bigtreetech/BTT-E3-RRF/BTT E3 RRF V1.1/3D/3D.png

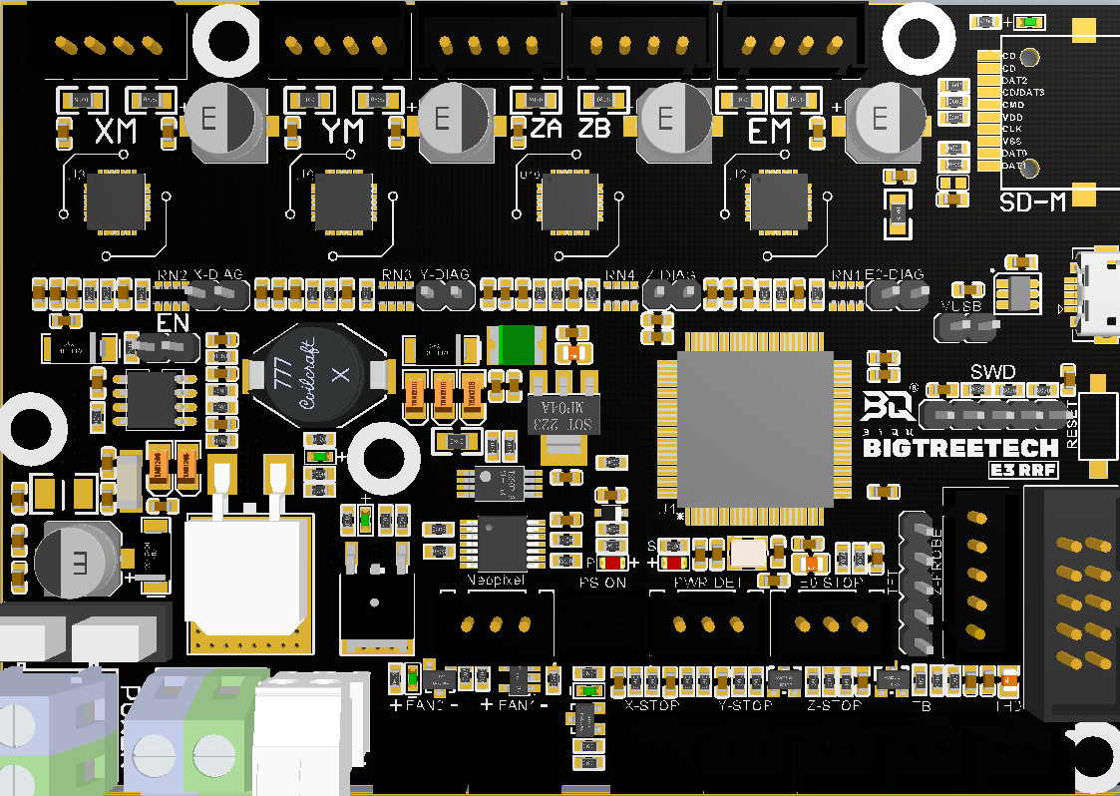
BTT E3 RRF V1.1/3D/3D.png
