bigtreetech/BTT-E3-RRF/README.md

## BTT-E3-RRF

### review
　You can find a complete review with detailed features of our electronics in [Spanish](https://3dwork.io/bigtreetech-e3-rrf) and [English](https://3dwork.io/en/bigtreetech-e3-rrf) on [3dwork.io](https://3dwork.io/).
