bigtreetech/BTT-E3-RRF/BTT E3 RRF V1.1/Firmware/RepRapFirmware/Ender3-IDEX/readme.md

# Firmware

Please download the latest version from https://github.com/gloomyandy/RepRapFirmware/releases  
The board is supported from release 3.3b1_5
