bigtreetech/BTT-E3-RRF/BTT E3 RRF V1.1/Firmware/E3 RRF 用户手册-For RepRapFirmware.pdf

前言

只有您需要 DIY 升级功能您才需要查看此文档，如果您是基础版的机器，直接更新我们 github 中预编译的 firmware.bin 文件即可正常使用。您可以在 Duet3D 官网找到所有配置的 详情，https://duet3d.dozuki.com/Wiki/Gcode。

一、 DWC(Duet Web Control)

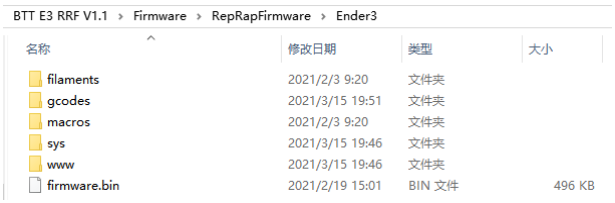
[picture p32: figure]

将我们 github 中的配置文件放到 SD 卡根目录，将卡插到主板然后 Reset，主板会自动更新 固件，更新成功后发送“M997 S1”更新 ESP8266 中的固件。
先发送 “M552 S0” 使 ESP8266 进入空闲模式，然后发送” M587 S"SSID" P"Password” “ 设置 要连接的 WIFI 名称和密码，然后发送“M552 S1” 使能网络控制，ESP8266 连接到 WIFI 后会 返回一个 IP 地址，在同一个局域网下的其他设备可以直接在浏览器中输入这个 IP 地址去访 问 DWC 界面

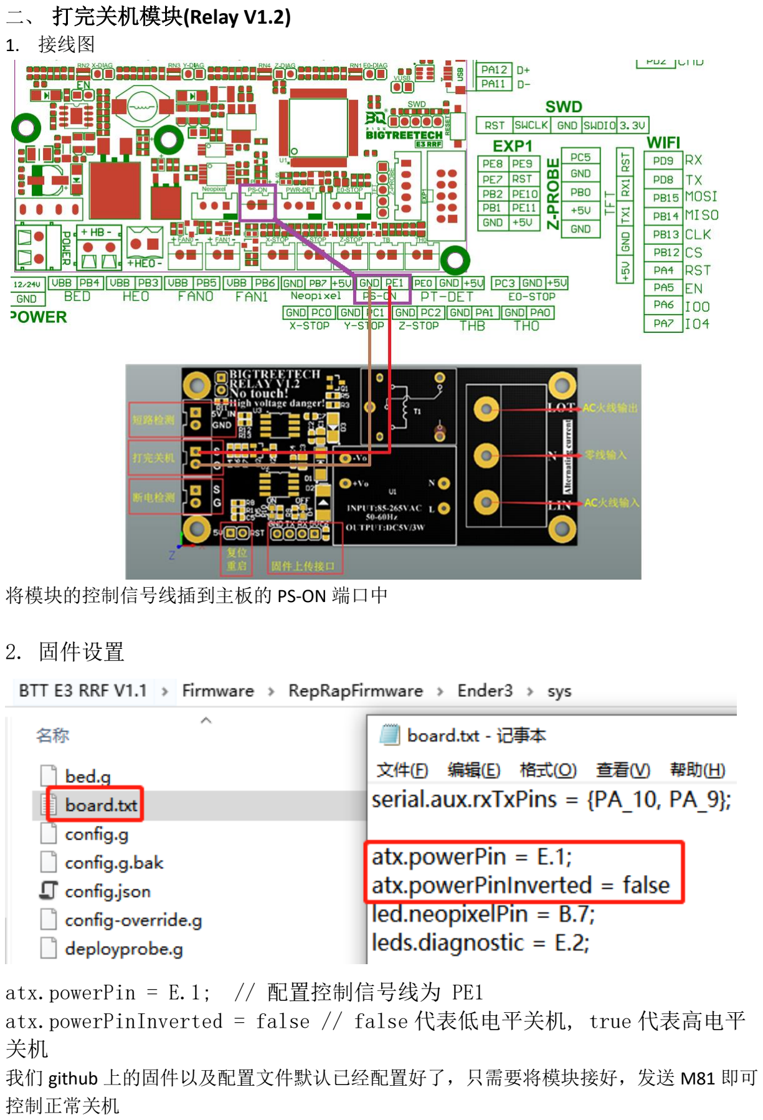
[picture p33: page 2]

二、 打完关机模块(Relay V1.2)
1. 接线图

将模块的控制信号线插到主板的 PS-ON 端口中

2. 固件设置

atx.powerPin = E.1; // 配置控制信号线为 PE1 atx.powerPinInverted = false // false 代表低电平关机, true 代表高电平 关机
我们 github 上的固件以及配置文件默认已经配置好了，只需要将模块接好，发送 M81 即可 控制正常关机

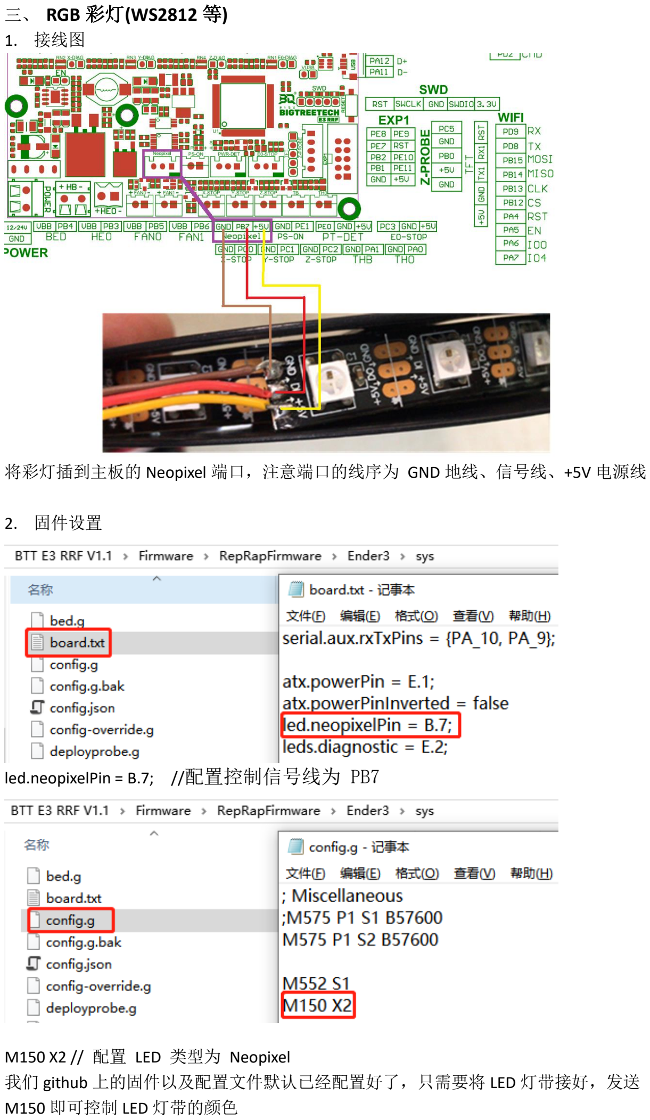
[picture p34: page 3]

三、 RGB 彩灯(WS2812 等)
1. 接线图

将彩灯插到主板的 Neopixel 端口，注意端口的线序为 GND 地线、信号线、+5V 电源线

2. 固件设置

led.neopixelPin = B.7; //配置控制信号线为 PB7

M150 X2 // 配置 LED 类型为 Neopixel
我们 github 上的固件以及配置文件默认已经配置好了，只需要将 LED 灯带接好，发送 M150 即可控制 LED 灯带的颜色

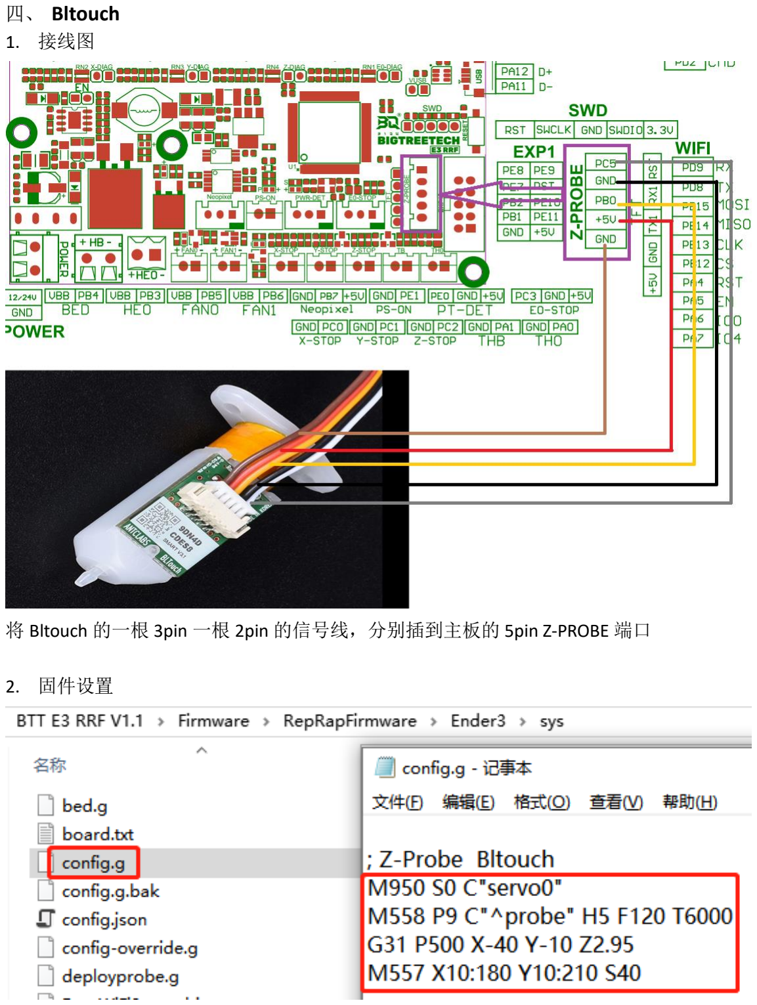
[picture p35: page 4]

四、 Bltouch
1. 接线图

将 Bltouch 的一根 3pin 一根 2pin 的信号线，分别插到主板的 5pin Z-PROBE 端口

2. 固件设置

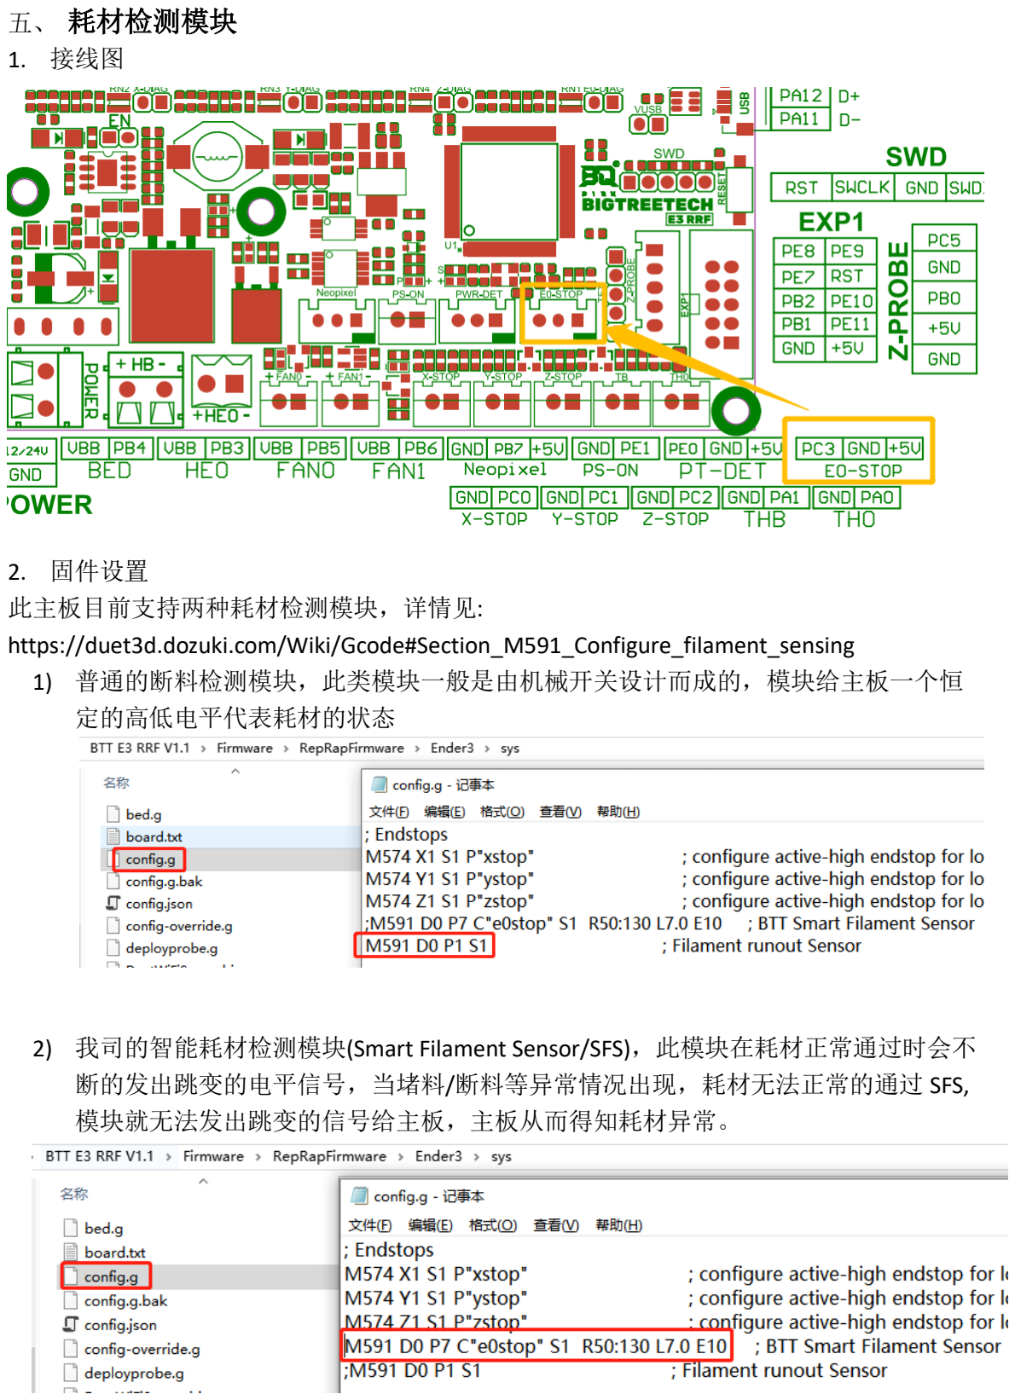
[picture p36: page 5]

五、 耗材检测模块
1. 接线图
2. 固件设置
此主板目前支持两种耗材检测模块，详情见:
https://duet3d.dozuki.com/Wiki/Gcode#Section_M591_Configure_filament_sensing
1) 普通的断料检测模块，此类模块一般是由机械开关设计而成的，模块给主板一个恒 定的高低电平代表耗材的状态
2) 我司的智能耗材检测模块(Smart Filament Sensor/SFS)，此模块在耗材正常通过时会不 断的发出跳变的电平信号，当堵料/断料等异常情况出现，耗材无法正常的通过 SFS, 模块就无法发出跳变的信号给主板，主板从而得知耗材异常。

六、 串口触控屏

设置屏幕的波特率为 57600(与 RRF 一致)

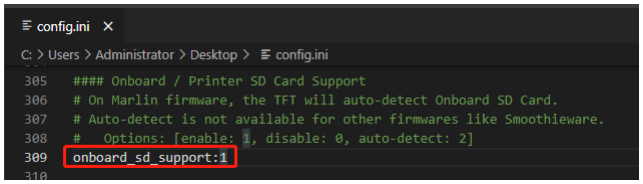
[picture p37: figure]

支持板载的 SD 卡

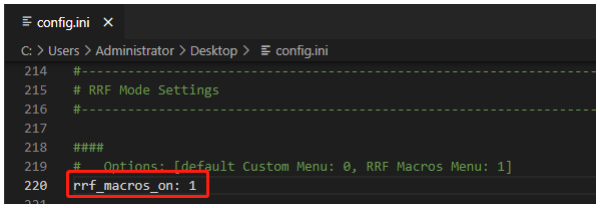
[picture p38: figure]

使能 Macros 界面
