bigtreetech/BTT-E3-RRF/BTT E3 RRF V1.1/Hardware/接线图.png

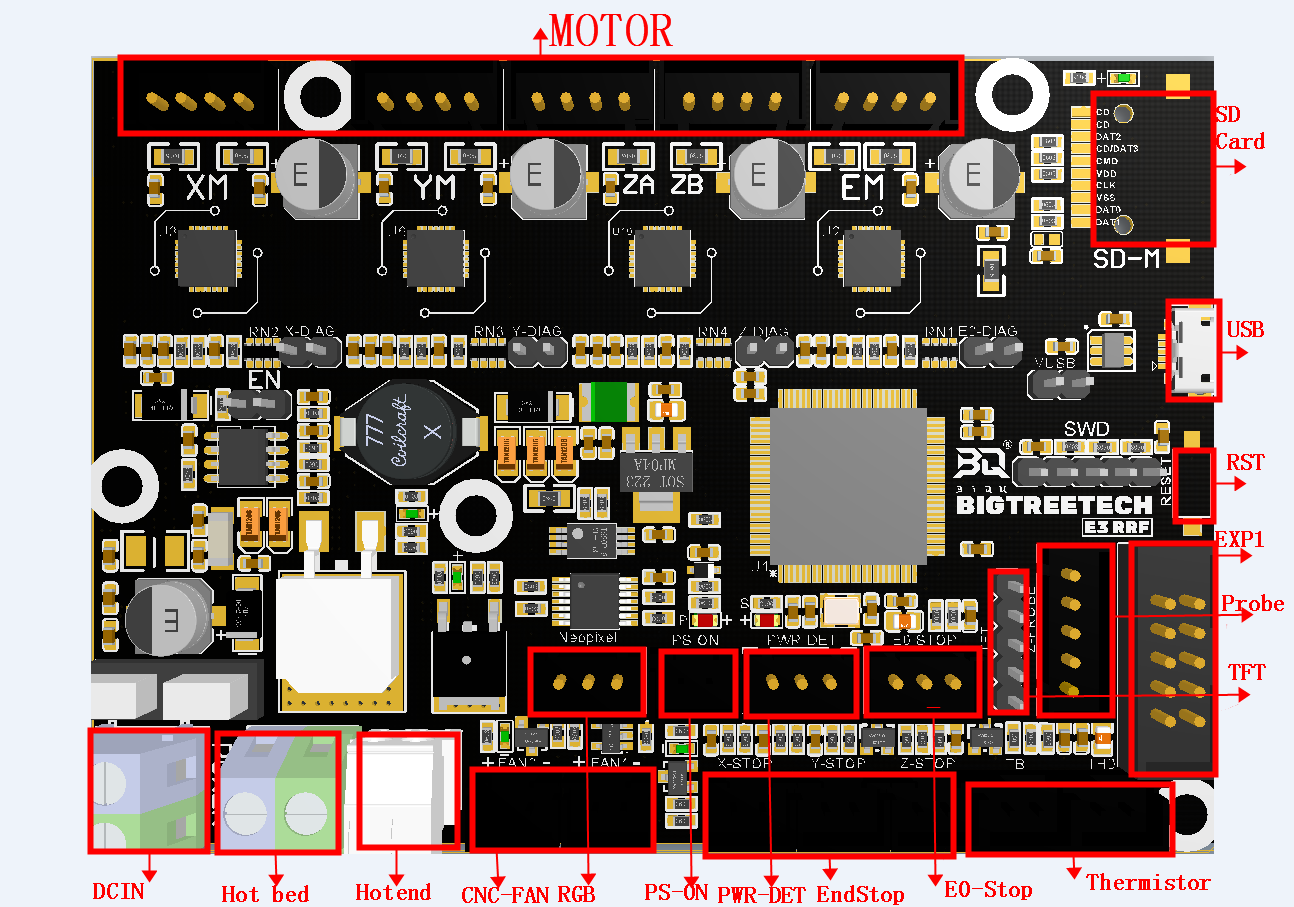
BTT E3 RRF V1.1/Hardware/接线图.png
