bigtreetech/BTT-E3-RRF/BTT E3 RRF V1.1/3D/ENDER32.STL

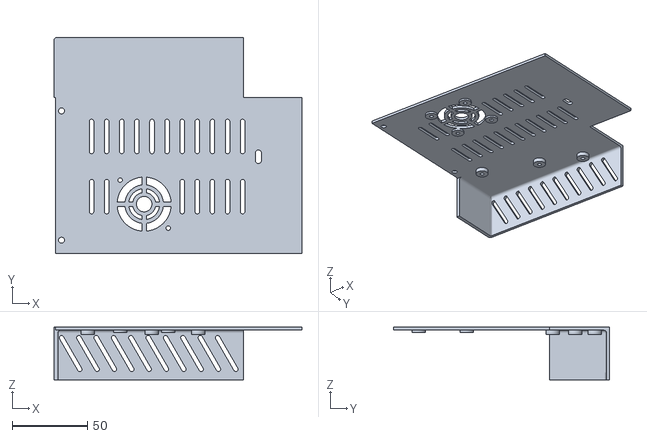
[picture p40: CAD file, 2021-05-18]
BTT E3 RRF V1.1/3D/ENDER32.STL
165.0 x 144.0 x 35.0
