bigtreetech/BTT-E3-RRF/BTT E3 RRF V1.1/3D/ENDER31.STL

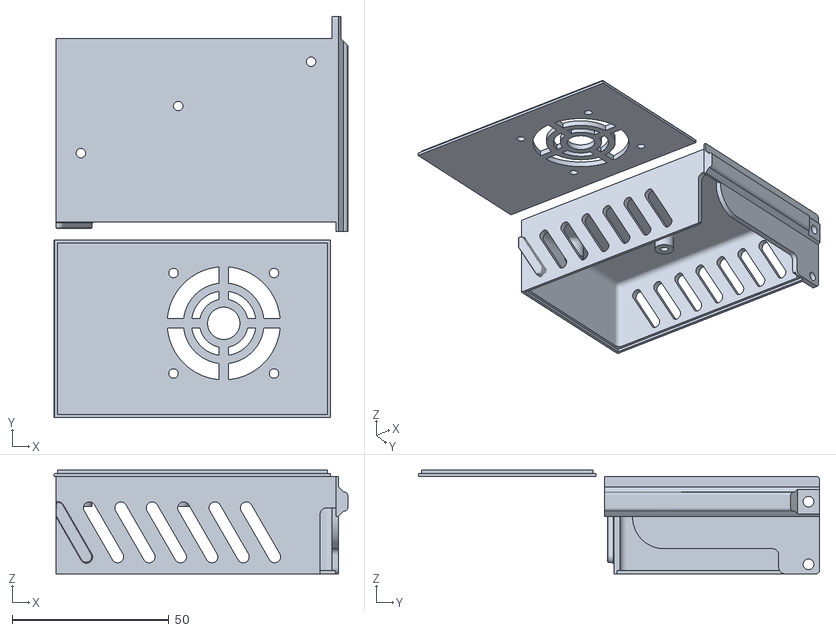
[picture p41: CAD file, 2021-05-18]
BTT E3 RRF V1.1/3D/ENDER31.STL
93.5 x 127.7 x 33.0
