bigtreetech/BTT-E3-RRF/BTT E3 RRF V1.1/Hardware/Support printer.txt

Support printer£º
		Ender-3¡¢Ender-3S¡¢Ender-3S Pro¡¢Ender-5¡¢CR-10¡¢CR-10mini¡¢Ender-3 V2
