bigtreetech/BTT-E3-RRF/BTT E3 RRF V1.1/Hardware/TUTORIAL ESP3D ENGLISH.pdf

## Build firmware ESP3D for BigTreeTech E3 RRF

Download in source firmware : ESP3D 2.1.1

1 : Extract ESP3D-2.1.1.zip (https://github.com/So6Rallye/BTT-E3-RRF-Marlin-2.0.7.2-wifi/blob/main/SOURCE%20FIRMWARE/ESP3D/ESP3D-2.1.1.zip) and copy the extract folder to the folder of your choice.

2 : Open Vscode and go to platformio extension. With platformio add folder ESP3D-2.1.1 extract previously.

3 : Now you need to configure the file platformio.ini for the wifi module ESP07S.

replace the parameters « dev » by :

| [env:esp07s] platform = espressif8266 board = esp07s framework = arduino monitor_speed = 115200

board_build.f_cpu = 80000000L board_build.f_flash = 40000000L
| board_build.flash_mode = qio
| you need to get this:

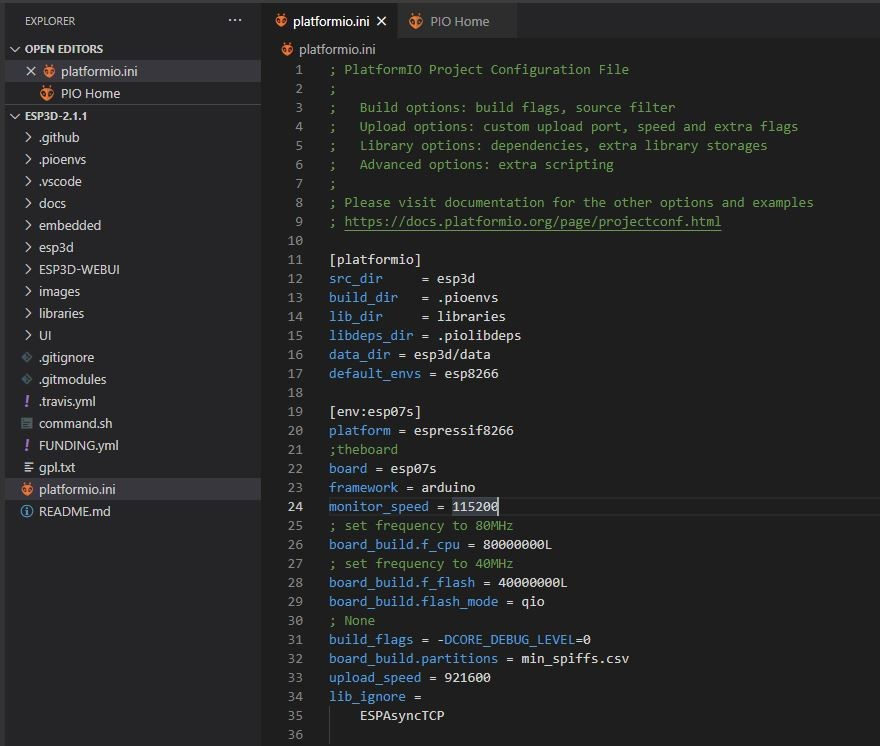
[picture p48: figure]

4 : Once these parameters are added you can successfully compile the firmware for ESP3D.

5 : the firmware is located in the starting ESP3D folder D:\USER\Document\ ESP3D-2.1.1\ESP3D-2.1.1\.pioenvs\esp8266

6 : Rename the firmware.bin file to ESP3D.bin

7 : Now all you have to do is copy this file into your SD card, insert it into your motherboard and turn on your printer. Wait a moment and your firmware is installed!

8 : Your printer is now available on your network, but there are still a few settings to activate so that your user interface works and your printer can connect to your network on its own.

9 : In your network manager connect you to ESP3D, open your browser and enter the base address 192.168.0.1 , the password is 12345678 .

10 : you are now connected to your printer, you will need to add the missing files in order to complete the configuration of your user interface.

11 : Go to your ESP3D folder and go to the folder D:\USER\Document\ESP3D-2.1.1\ESP3D-2.1.1\esp3d\data

you must find this:

404
favicon
index.html

12 : copy the three files into your web interface and click upload

13 : Once the download is complete you can proceed to the web interface configuration step.

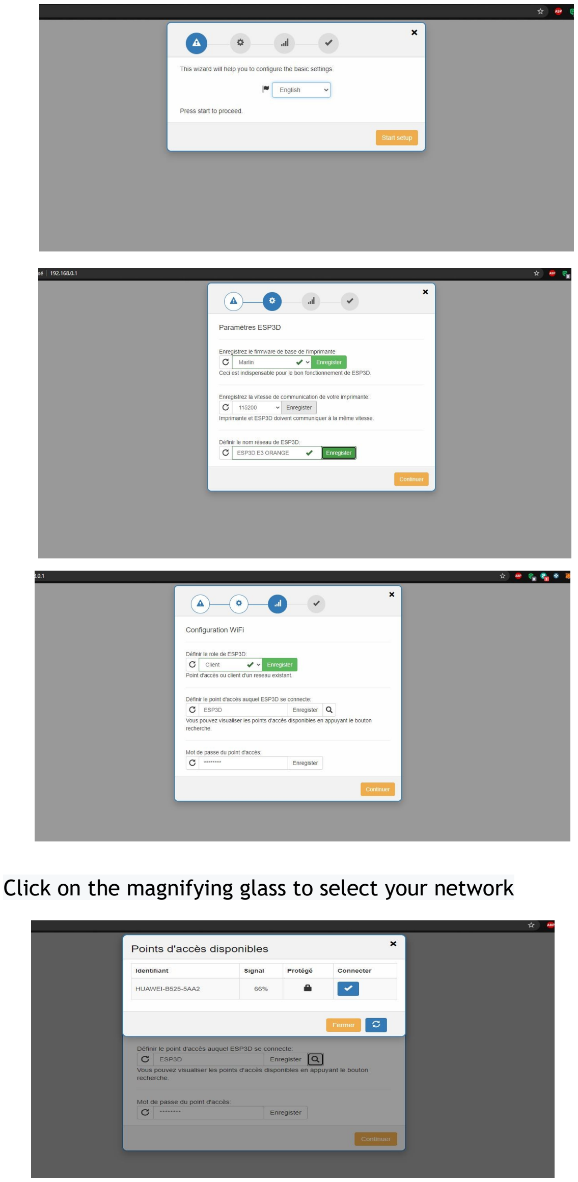
[picture p49: page 3]

Click on the magnifying glass to select your network

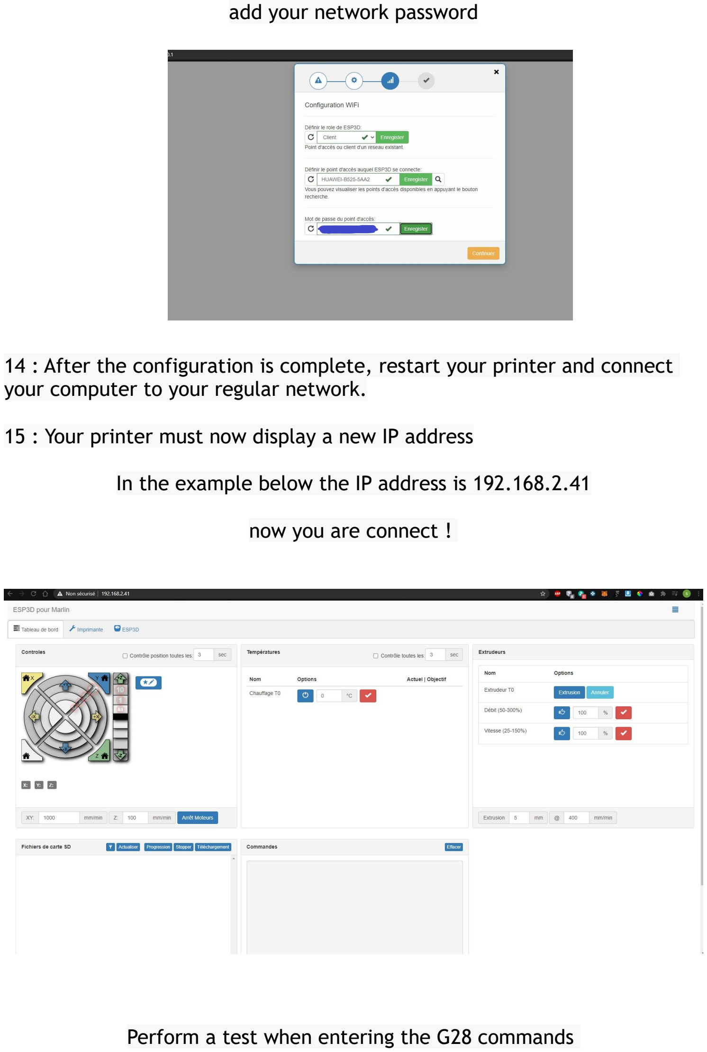
[picture p50: page 4]

add your network password

14 : After the configuration is complete, restart your printer and connect your computer to your regular network.

15 : Your printer must now display a new IP address

In the example below the IP address is 192.168.2.41

now you are connect !

Perform a test when entering the G28 commands your printer communicates with your network and realizes are AUTOHOME

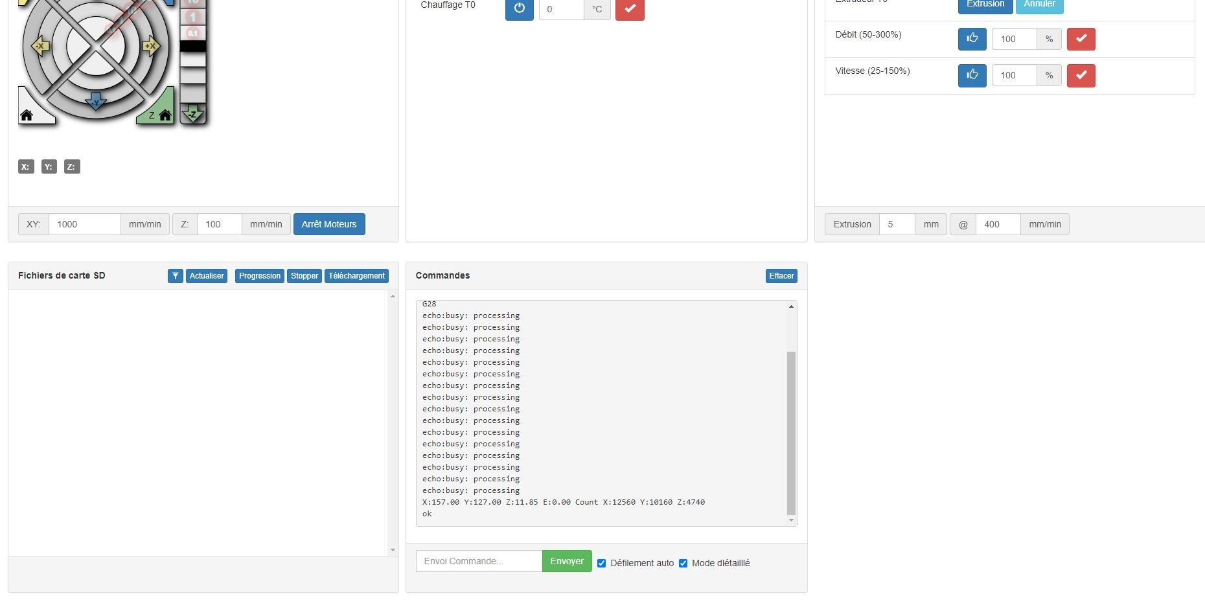
[picture p51: figure]

The installation is complete, you can configure your ESP3D and printer from the user interface.

Create by So’6 Rallye
