bigtreetech/BTT-E3-RRF/BTT E3 RRF V1.1/Hardware/TUTORIAL ESP3D FRANCAIS.pdf

## Build firmware ESP3D for BigTreeTech E3 RRF

Télécharger dans source firmware : ESP3D 2.1.1

1 : Extraire ESP3D-2.1.1.zip (https://github.com/So6Rallye/BTT-E3-RRF-Marlin-2.0.7.2-wifi/blob/main/SOURCE%20FIRMWARE/ESP3D/ESP3D-2.1.1.zip) et copier le dossier dans celui de votre choix.

2 : Ouvrir Vscode et aller sur l’extension platformio. Avec platformio ajouter le dossier ESP3D-2.1.1 extrait précédemment.

3 : Maintenant vous devez configurer le fichier platformio.ini pour le module wifi ESP07S.remplacer les paramètres « dev » par :

| [env:esp07s] platform = espressif8266 board = esp07s framework = arduino monitor_speed = 115200

board_build.f_cpu = 80000000L board_build.f_flash = 40000000L board_build.flash_mode = qio


| vous devez obtenir ceci :

4 : Une fois ces paramètres ajoutés vous pouvez compiler le firmware avec succès pour l’ESP3D.

5 : le firmware ce situe dans le dossier ESP3D de départ D:\USER\Document\ ESP3D-2.1.1\ESP3D-2.1.1\.pioenvs\esp8266

6 : Renommez le fichier firmware.bin en ESP3D.bin

7 : Maintenant il ne vous reste plus qu’à copier ce fichier dans votre carte SD, l’insérer dans votre carte mère et d’allumer votre imprimante. Patientez un moment et votre firmware est installer !

8 : Votre imprimante est désormais disponible sur votre réseau mais il reste quelques paramètres à activer afin que votre interface utilisateur fonctionne et que votre imprimante puisse ce connecter d’elle même à votre réseau.

9 : Dans votre gestionnaire de réseau connecter vous à ESP3D, ouvrer votre navigateur et entrer l’adresse de base 192.168.0.1 , le mot de passe est 12345678 .

10 : vous êtes désormais connecter à votre imprimante, il va falloir ajouter les fichiers manquants afin de terminer la configuration de votre interface utilisateur.

11 : Allez dans votre dossier ESP3D et rendez vous dans le dossier D:\USER\ Document\ESP3D-2.1.1\ESP3D-2.1.1\esp3d\data

vous devez trouver ceci :

404
favicon
index.html

12 : copier les trois fichiers dans votre interface web et cliquer sur upload

13 : Une fois le téléchargement terminer vous pouvez passer à l’étape de configuration de l’interface web.

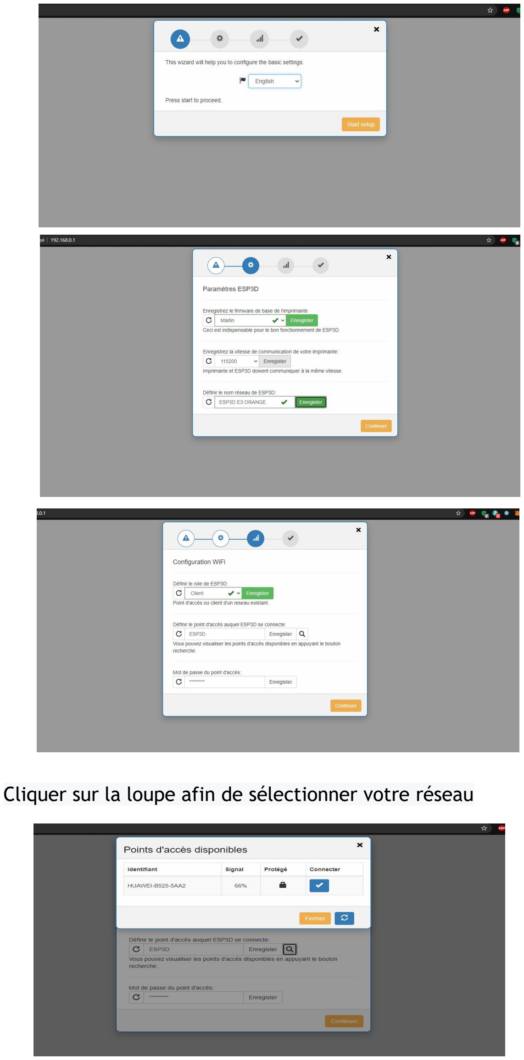
[picture p52: page 3]

Cliquer sur la loupe afin de sélectionner votre réseau

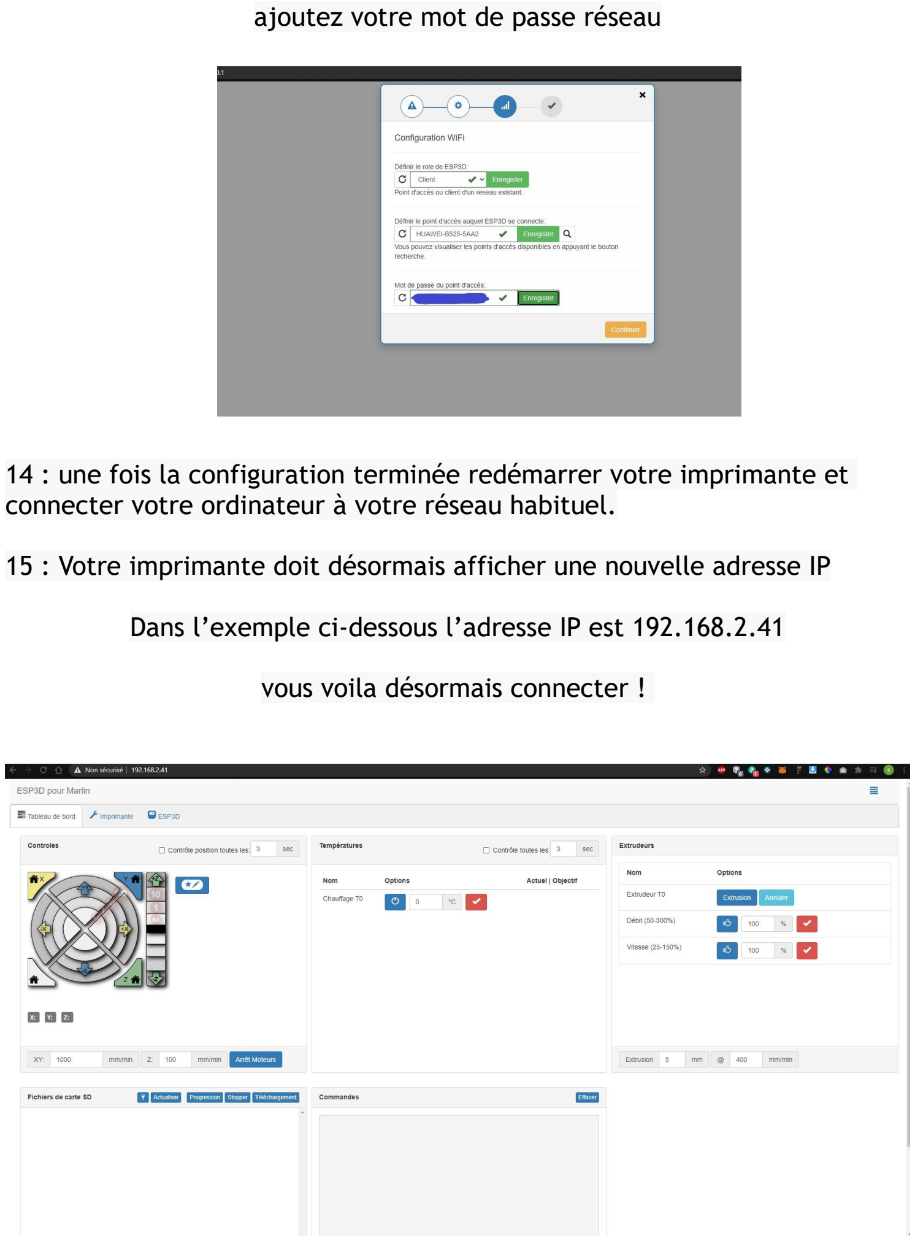
[picture p53: page 4]

ajoutez votre mot de passe réseau

14 : une fois la configuration terminée redémarrer votre imprimante et connecter votre ordinateur à votre réseau habituel.

15 : Votre imprimante doit désormais afficher une nouvelle adresse IP

Dans l’exemple ci-dessous l’adresse IP est 192.168.2.41

vous voila désormais connecter !

Faite un test en entrant dans les commandes G28

votre imprimante communique avec votre réseau et réalise sont AUTOHOME


Voilà l’installation est terminée, vous pouvez configurer votre ESP3D et votre imprimante depuis l’interface utilisateur.

Créer par So’6 Rallye
