bigtreetech/BTT-E3-RRF/BTT E3 RRF V1.1/Hardware/TUTORIAL MARLIN ENGLISH.pdf

## Build firmware Marlin 2.0.7.2 for BigTreeTech E3 RRF

download in source firmware : MARLIN 2.0.7.2

1 : Create folder Marlin in your directory « C:\
exemple: C:\marlin
2 : unzip | Marlin-2.0.7.2.x-E3-RRF.rar (https://github.com/So6Rallye/BTT-E3-RRF-Marlin-2.0.7.2-wifi/blob/main/SOURCE%20FIRMWARE/MARLIN%202.0.7.2/Marlin-2.0.7.2.x-E3-RRF.rar) | and copy the extract folder to « C:\marlin

3 : open Vscode and go to platformio extensions. With platformio add folder from your C:\marlin\ Marlin-2.0.7.2.x-E3-RRF (https://github.com/So6Rallye/BTT-E3-RRF-Marlin-2.0.7.2-wifi/blob/main/SOURCE%20FIRMWARE/MARLIN%202.0.7.2/Marlin-2.0.7.2.x-E3-RRF.rar)

4 : Now you can configure your files configuration.h and configuration_adv.h as you wish, with or without bltouch, neopixel, filament sensor etc ….

IMPORTANT : before build your marlin you need to have these settings to enable the wifi module

| | configuration.h

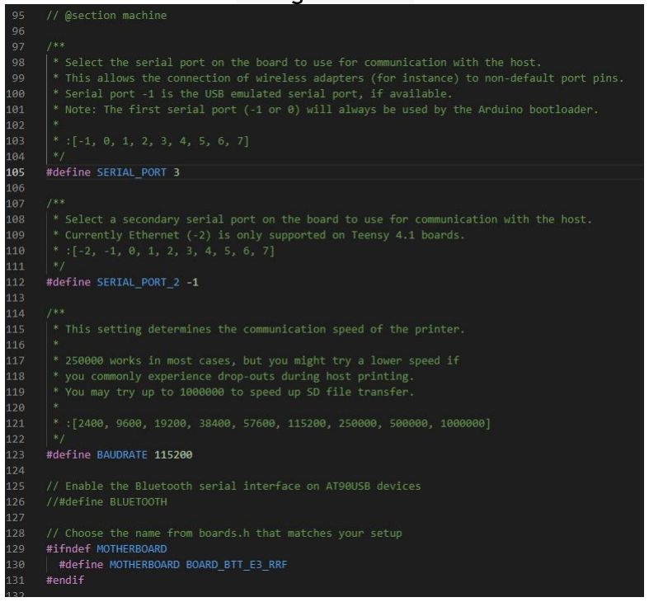
[picture p54: figure]

be sure to
#define SERIAL_PORT 3

#define SERIAL_PORT_ 2 -1

#define BAUDRATE 115200

configuration_adv.h

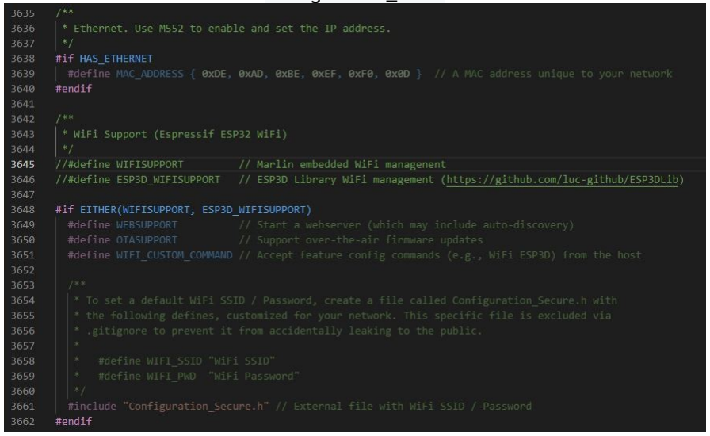
[picture p55: figure]

be sure don’t uncomment

//#define WIFISUPPORT
#define ESP3D_WIFISUPPORT

5 : Now you can build your firmware and have success compil

6 : the firmware is located in the folder C:\marlin\Marlin-2.0.7.2.x-E3-RRF\.pio\build\BIGTREE_E3_RRF

!! Be sure the firmware must absolutely be called firmware.bin before you copy into your board.

7 : when the file is in your Sdcard you have to put into your board and turn on your printer. Wait a moment and firmware is upload !

now we need to activate the wifi module so that it can communicate with your networks. Please refer to TUTORIAL ESP3D.

Create by So’6 Rallye
