bigtreetech/BTT-E3-RRF/BTT E3 RRF V1.1/Hardware/TUTORIAL MARLIN FRANCAIS.pdf

## Build firmware Marlin 2.0.7.2 for BigTreeTech E3 RRF

Télécharger dans source firmware : MARLIN 2.0.7.2

1 :Créer un dossier Marlin dans votre répertoire « C:\
exemple: C:\marlin

2 : Extraire Marlin-2.0.7.2.x-E3-RRF.rar (https://github.com/So6Rallye/BTT-E3-RRF-Marlin-2.0.7.2-wifi/blob/main/SOURCE%20FIRMWARE/MARLIN%202.0.7.2/Marlin-2.0.7.2.x-E3-RRF.rar) et copier le dossier extrait dans « C:\ marlin

3 : Ouvrir Vscode et aller sur l’extension platformio. Avec platformio ajouter le dossier provenant de votre répertoire C:\marlin\ Marlin-2.0.7.2.x-E3-RRF (https://github.com/So6Rallye/BTT-E3-RRF-Marlin-2.0.7.2-wifi/blob/main/SOURCE%20FIRMWARE/MARLIN%202.0.7.2/Marlin-2.0.7.2.x-E3-RRF.rar)
4 : maintenant vous pouvez configurer vos fichiers configuration.h et configuration_adv.h comme vous le souhaitez, avec ou sans bltouch, neopixel, capteur filament etc ….

IMPORTANT : Avant de compiler votre marlin vous devez avoir ces paramètres afin d’activer le module wifi.

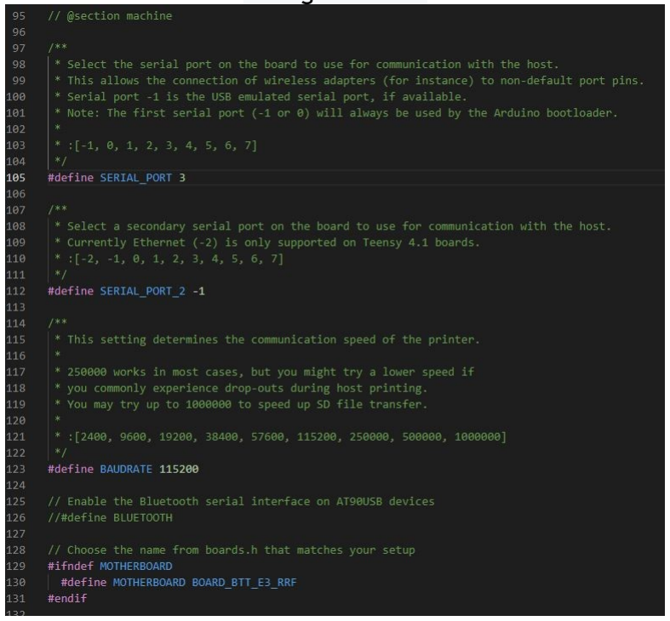
[picture p56: figure]

configuration.h soyez sûr d’avoir ces paramètres activés

#define SERIAL_PORT 3

#define SERIAL_PORT_ 2 -1

#define BAUDRATE 115200

configuration_adv.h

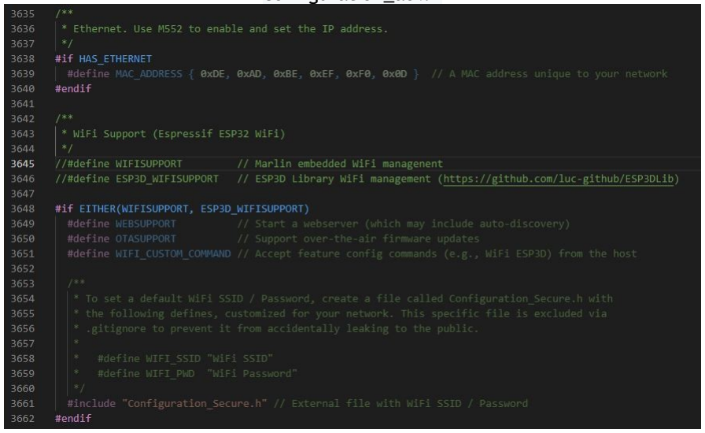
[picture p57: figure]

Soyez sûr de ne pas dé-commenter

//#define WIFISUPPORT
//#define ESP3D_WIFISUPPORT

5 : Maintenant vous pouvez compilé votre firmware avec succès

6 : Le firmware ce situe dans le dossier C:\marlin\Marlin-2.0.7.2.x-E3-RRF\.pio\build\BIGTREE_E3_RRF

!! Soyez sûr que le firmware s’appelle firmware.bin avant de le copier dans votre carte.

7 : Lorsque le fichier est copier dans votre carte SD vous devez l’insérer dans votre carte mère et allumer l’imprimante. Patientez un moment et votre firmware est désormais télécharger dans votre carte mère !

Maintenant nous devons activer le module wifi afin qu’il communique avec votre réseau. S’il vous plaît référer vous au dossier TUTORIAL ESP3D.

Créer par So’6 Rallye
