bigtreetech/BTT-E3-RRF/(threads)

Thread 1 (2021-03-29):

3D model bug

trengtor, 2021-03-29:
3D model (step) without mount holes

GadgetAngel, 2021-05-21:
Can you make the 3D model available in PDF format?

Kung-Foo-Kamel, 2021-11-21:
I found this issue as well, also the dimensions PDF does not show all measurements for the mounting holes.

I will assume this board is just abandon-ware, they have not bothered to reply to this, and its a pretty legit issue with the data provided in the GIT and should have been an easy fix.

The BTT team have probably moved on to other projects and see this one as complete, even the firmware/software has been offloaded to others.

Thread 2 (2021-04-06):

Neopixel

psycho0170, 2021-04-06:
How many leds can o conect directly to the motherboard. Is there a power supply to connect more leds as on the SKR 1.4?

Dext65, 2021-04-11:
The power supply unit is already incorporated, you can power 30 leds.

Thread 3 (2021-04-10):

btt tft 35 v2 or 3 or btt mini 12864 v1

mitofun, 2021-04-10:
hi how are you?
actually i am trying to connect tft 35 or mini 12864 v1 to the boart btt e3 rrf- through reprap and no luck((( https://teamgloomy.github.io/Configurator/Start using this one!)

could you please assist me - need to know the pin for RX1 and RT1 on the board? how should i write it on the firmware?
also if i try to do it frough the marlin no luck (((
this message i get- buildroot/share/PlatformIO/scripts/../../../../Marlin/src/inc/../pins/stm32f4/pins_BTT_E3_RRF.h:286:6: error: #error "Only CR10_STOCKDISPLAY, ZONESTAR_LCD, ENDER2_STOCKDISPLAY, MKS_MINI_12864, and TFTGLCD_PANEL_(SPI|I2C) are currently supported on the BTT_E3_RRF."
so when you will do support for btt tft 35 v2 and v3 and btt mini 12864 v1& thank you

psycho0170, 2021-04-12:
Hi, i have the same issue. If you use 1 of the 3 firmware archives that are precompiled you can use it but i would like to configure my Marlin and i can't due to the same issue: #error "Only CR10_STOCKDISPLAY, ZONESTAR_LCD, ENDER2_STOCKDISPLAY, MKS_MINI_12864, and TFTGLCD_PANEL_(SPI|I2C) are currently supported on the BTT_E3_RRF." I would like to know what kind of display i should select to compile my firmware. Thank you.

mitofun, 2021-04-12:
> Hi, i have the same issue. If you use 1 of the 3 firmware archives that are precompiled you can use it but i would like to configure my Marlin and i can't due to the same issue: #error "Only CR10_STOCKDISPLAY, ZONESTAR_LCD, ENDER2_STOCKDISPLAY, MKS_MINI_12864, and TFTGLCD_PANEL_(SPI|I2C) are currently supported on the BTT_E3_RRF." I would like to know what kind of display i should select to compile my firmware. Thank you.

hi you leave the cr 10 - connect your tft 35 or other to the board + exp3 from tft to exp1 to the board - and install the firmware- works fine))))
this is under marlin mode)
under the rrf  i have managed to log in under the wifi but not to connect the tft (((

mitofun, 2021-04-12:
under the tft mode (marlin firmware) you cannot use the btt tft 35 - so the question to the BIUQ when you will do the upgrade in the firmware so marlin will supports your tfts? thank you

mitofun, 2021-04-12:
wow i have managed to connect the tft in marlin mode) works good!)))

mitofun, 2021-04-12:
> Hi, i have the same issue. If you use 1 of the 3 firmware archives that are precompiled you can use it but i would like to configure my Marlin and i can't due to the same issue: #error "Only CR10_STOCKDISPLAY, ZONESTAR_LCD, ENDER2_STOCKDISPLAY, MKS_MINI_12864, and TFTGLCD_PANEL_(SPI|I2C) are currently supported on the BTT_E3_RRF." I would like to know what kind of display i should select to compile my firmware. Thank you.

have managed to connect the tft 35 v3 to the board- in marlin mode))) so all you need to do 👍
1- in marlin https://github.com/bigtreetech/BTT-E3-RRF open the ender 3 - and set up to your printer paraments- the lcd leave as it is!  for nepixels the pin is pb7- compile and upload the firmware to the board)
2- https://github.com/bigtreetech/BIGTREETECH-TouchScreenFirmware this is firmware for the tft-
download and safe to the sd - in the folder - copy to sd card.... the bin file (according to you tft) and the config.ini + theme (tft 35 in my case) and upload it to the tft)
if you have questions you can contact me - +79091151215 whatsap viber telegram etc)

psycho0170, 2021-04-12:
Hi, the only way I can have the touch screen function is uploading last firmware to the screen and then uploading to the board 1 of the 3 firmwares.bin that there are precompiled in the BTT-E3-RRF repository. If i try to compile my own firmware with the Marlin from the repository i always have the same issue: if i not change the screen i cant manage the board from the screen and if i change the screen i havevthe message in visual studio that BTT-E3-RRF board dont support it. So, what kind of screen i have to compile in Marlin to make the touch screen function with board?

Kung-Foo-Kamel, 2021-04-14:
Honestly, if you use Reprap Firmware I would take any display connected to this board and unplug it, and drop it in a draw or a spare parts box, its next to useless, you are by far better off using the web gui, anything you do on the display will only mess things up, some of the features and settings just don't work, and if your to quick with it, it will lock up and you need to reboot the machine to make it work again, all its good for is a basic status display, which you can do with a defunct mobile or tablet through the DWC.

I know its not answering your question, but I should have just saved the money, now that I know, I wont make the mistake again, the RRF web interface is awesome, in every way its better than the little touch display, provided the Wireless performance can improved.

psycho0170, 2021-04-15:
Hi, I dont know how to use reprap, i never tried it. I even dont know how to conect the printer by wifi. Could you explain It a bit please. Thank you.

Kung-Foo-Kamel, 2021-04-15:
Are you on reddit? if so hit me up on their, same name, I will create a post on how to get this board up and running with Reprap, including how to get it started with BT-Touch, as it wont work with the default settings found in this repository.

Kung-Foo-Kamel, 2021-04-15:
Here following this link to my little post: https://www.reddit.com/r/BIGTREETECH/comments/mrcxsv/getting_the_new_bttrrfe3_v10v11_up_and_running/

jaysuk, 2021-04-19:
we also have instructions here https://teamgloomy.github.io/skr_rrf_e3_general.html

Thread 4 (2021-04-14):

Wifi Performance

Kung-Foo-Kamel, 2021-04-14:
Hi,

I have everything setup properly, but Wifi performance is extremely bad, its like dial up modem speed, when transferring large files it often fails, and after a while the DWC becomes unusable requiring a reboot of the mainboard.

I have checked and I have 75% signal strength, running a Ubiquity AP in the same room, Antenna is outside the metal chassis, I have searched online for any way to alter additional settings on the ESP8266 but I have only found the basics.

I have tested both mainboard and Wifi firmware from this repository and gloomyandy, both suffer from the same issue.

Also anything over 10mb will not transfer, have managed to to get it about 87% signel strength, it now transfers at a stable 39Kb per second...woohoo smoking :)

trengtor, 2021-04-14:
Try to minimize power yours acces point/router.

Kung-Foo-Kamel, 2021-04-14:
Do you mean reduce the output power of my wifi router?

I don't think there is anything incorrect with my Access points, I have a very solid and well managed network, the only thing in my network that is not functioning correctly is this ESP8266.

I run 3 Mesh Amplifi HD's by Ubiquity with gigabit cabled backhaul 3 managed gigabit switches and even the cheapest low-end IOT device on my wifi network is 100% stable, so messing with my Access points will only inhibit other devices from operating at peek performance.

Any advice on how to change what channel its using and how to alter is bandwidth? I feel this may be the problem, but I don't know the console commands to view or alter these features, would be nice if there was a wiki for this board outlining some of these basic commands.

Kung-Foo-Kamel, 2021-04-15:
Update: Disabling the CRC Check will allow stable 300KB transfer rates and I can now transfer over 20MB files without issue, but when trying to copy back to PC, the transfer fails again, I assume its applying the CRC checking on the other end now.

So it doesn't look like a baud rate bottle neck, its possibly something to do with the CRC file checking.

trengtor, 2021-04-17:
> Do you mean reduce the output power of my wifi router?

Yes. This will improve the operation of the radio receiving part of the WiFi module. These are the nuances of radio communication (implementation of receivers in inexpensive WiFi), not a protocol stack.

Kung-Foo-Kamel, 2021-04-18:
I cant do that, the Amplifi HD doesn't have this option, and even if it did, I would prefer to keep it maxed out to squash competing wifi networks, I shouldn't have to retard my wifi network when nothing else is having issues, I'd prefer this device to operate correctly.

I run 3 of these HD's so my property has full coverage, I have IOT devices in close and distant proximity to my AP's all perform great, quite a few of them are running ESP based WiFi boards too, the closest one being about 2 meters from one of the AP's.

Something else to add, I have owned hundreds of different WiFi routers and devices over the past 20yrs, and by far, these Amplifi HD's are the best I have ever had the pleasure of using, they will even beat some of the high end WiFi 6 routers in latency, which I have personally tested and measured as I use them for Wireless VR.

I have found settings in DWC that give me 100% reliability now, but transfer speed is about 40kb per sec, if you disable CRC checking this will rise up to 300kb, at the end of the day, speed does not concern me as prints take hours, so I just upload while its printing something else.

Closed 2021-04-18.

Thread 6 (2021-04-14):

USB U-Disk Read Error

Kung-Foo-Kamel, 2021-04-14:
I'm running the TFT35 E3 v3 with the latest firmware, I cant seem to get the USB port to read a USB drive, have tried several USB Flash drives, tried all the usual formats FAT32/NTFS/exFAT it detects the drive being inserted, but gives a read error when trying to access it.

Any advice on what I'm doing wrong here?

I kind of need this to work as transfering gcode files over wifi wont work due to issues with the wifi mentioned in another thread, I feel powering down the machine and pulling the SDcard all the time is not really a good option.

jaysuk, 2021-04-19:
what firmware are you running?
If its RRF, it doesn't support external SD card readers or USB drives

Kung-Foo-Kamel, 2021-04-30:
1. Not an issue anymore as I have decided to remove the display as its complete waste of space, time, money and effort.
2. It does support printing from the SDCARD and USB slot, as these are functions built into the display's GUI and can be accessed from the touch menu, Print -> U-Disk or Print -> TFT SD
3. Reading and printing from the SDCARD in the display slot works
4. Any attempt to read a USB drive will fail
5. Printing from an SDCARD through the display slot will usually fail after a few hours
6. If these features not supported, then I suggest removing all reference of them from the ReRap GUI on the TFT35
7. Also Print -> Onboard SD is useless unless all your gcode's are in the main gcode directory, heaven forbid you try and organise your files in sub directory's.

Closed 2021-04-30.

Thread 7 (2021-04-15):

Error: Unknown board ID 'BigTree_E3_RRF'

cjsieh, 2021-04-15:
Using PlatformIO to compile  Marlin-2.0.7.2.x-E3-RRF on linux(Ubuntu) using Vscode gives the error

  " Error: Unknown board ID 'BigTree_E3_RRF' "

This can be fixed by changing the name of the file

BIGTREE_E3_RRF.json
 to
BigTree_E3_RRF.json

in directory
BTT-E3-RRF/BTT E3 RRF V1.1/Firmware/Marlin/Ender3/Marlin-2.0.7.2.x-E3-RRF/buildroot/share/PlatformIO/boards/

PlatformIO is case sensitive about the entry of "board" in platformio.ini because this entry is used to build a filename and  Linux filenames are case sensitive.

The default git repo builds fine on Windows 10 as Windows 10 does not have case sensitive filenames .

keslerm, 2021-10-02:
Thank you for posting this, helped me out

Thread 8 (2021-04-16):

ERROR: M221 No Tool Selected

Wombat37, 2021-04-16:
I've just set up a BTT-E3-RRF board with a BTT-E3-TFT35 display on an Ender 3 Pro printer.

Latest firmware was uploaded to both boards (RRF dated April 8 and TFT 3.0.E3.27). All seems to work OK except that when the hot end heater is in standby or off (on boot or set manually from DWC), a persistent M221 No Tool Selected error is displayed on the TFT display which cannot be removed and so renders the whole printer useless. Using DWC to reset the hot end heater to active clears the error on the display and it becomes functional again.

It took hours to track this down. Hopefully, I've made a mistake in editing one of the configuration files or it's a bug that's quick to fix.

Wombat37, 2021-04-16:
Sorry - I should have said that I set this up in RepRap mode.

Wombat37, 2021-04-16:
Work around...

Put this in the config.g file near the end, after the ;Tools section

M104 S0 T0
T0

This puts the hot-end heater into active mode set to 0°C and the No Tool Selected error doesn't occur!

Thread 9 (2021-04-17):

PID Autotune of Hotend and Bed doesn't work on E3-RRF and Ender 3 Pro from TFT35

Wombat37, 2021-04-17:
Selecting PID Autotune of Hotend or Bed on TFT35 screen is not working under RepRap system. Autotune operation is confirmed but nothing heats up and eventually the system times out. Latest firmware in both boards.

Works OK from DWC using

M303 H1 P1 S220 C8 ;Hotend PID autotune

or

M303 H0 P1 S60 C8 ;Bed PID autotune

jaysuk, 2021-04-19:
I suggest raising this on this TFT github and not here as its a TFT issue.
Also "C" as an argument on tuning is a Marlin thing and not RRF

Wombat37, 2021-04-19:
Thanks jaysuk for the response. I wasn't too sure where to post this issue. The TFT user interface shows the right dialog but somewhere in the system, the command to perform the PID autotune was getting lost. I don't know which board is doing the losing! My money was on the RRF board because it's new.

Regarding the C argument, the following was taken from the RepRap Wiki (https://reprap.org/wiki/PID_Tuning). It's also listed as a valid argument in the list of RepRap g codes at: https://reprap.org/wiki/G-code#M303:_Run_PID_tuning

M303 E0 S200 C8

This didn't work with the E0 argument ("no heater has been tuned since startup") but did with the H0 and H1

The T0 argument is not mentioned in the RepRap Wiki or in the official list of g codes for RepRap so you can understand my confusion regarding your posting. However, it did seem to work.

As a newcomer to RRF, this has been my biggest challenge - everywhere you look, there appears to be different answers. It's also apparent that people with experience seem to know the right answers - where did they get them from?

I'm not trying to be negative - I'm just trying to understand this system which looks great but not everything is working properly.

jaysuk, 2021-04-20:
Its definitely not getting lost by the firmware.
The port to STM32 boards is pretty mature now and has been around for about 8 months now, whereas the TFT firmware has been very flaky until the last month or so.

I wouldn't be using the reprap.org page as it seems to be fairly out of date regarding all the arguments to use.
This page is pretty much your bible https://duet3d.dozuki.com/Wiki/Gcode and you can see that the T arguement is listed for RRF versions 3.2 or greater https://duet3d.dozuki.com/Wiki/Gcode#Section_M303_Run_heater_tuning
We're also quite friendly on our discord channel https://discord.gg/uS97Qs7

Wombat37, 2021-04-21:
Hi jaysuk, thanks for the clarification and for taking the time to respond so fully - it really is much appreciated. I'm still finding my feet with this stuff and welcome the advice you gave on where to get accurate and up-to-date information.

I agree with your assessment of the TFT firmware - it is very flaky and I've had many lockups and crashes - often difficult to reproduce precisely.

Should I be trying to report all this stuff in GitHib? (Evaluating instrumentation firmware was part of my job before retiring).

jaysuk, 2021-04-21:
If there's any issues you find with the TFT firmware etc then please do raise it on github.
BTT have only recently been interested in supporting RRF on the TFT's so they need all the help they can get.
If you have any issues with RRF itself, we would prefer you to report them on the discord channel above. Our developer is around most days and it makes it a lot easier to bug hunt etc in real-time rather than back and forth through github.

f1vefour, 2021-04-22:
@jaysuk Yeah but if the bug reappears there will be no information on GitHub to reference if the discussion takes place in discord.

jaysuk, 2021-04-22:
@f1vefour That would be fine if BTT managed the RRF firmware that runs on the board but they don't.
It relies on our port (TeamGloomy).
Hence Discord is the place to go to report any bugs, not here.

f1vefour, 2021-04-23:
I meant on your git not here, for issues related to the firmware not this
particular instance.

I'm happy it's been ported regardless, the work which has been done is
amazing and I thank everyone involved.

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

jaysuk, 2021-04-23:
We also don't use our git for issue tracking. We use Discord.
Much easier to problem solve issues on the spot than play post tennis.
And pretty much any real issue that gets raised is a duet issue anyway.

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

Kung-Foo-Kamel, 2021-04-30:
The fix is to unplug the TFT35 and throw it in a draw and forget about using it all, just use a web interface and put up with the slow wifi throughput.

Display cant read subfolders when trying to print, printing from a flash drive in the display will fail after a few hours, the ABL features are nerfed and wont function the same as the web interface, if you do too many things on the display it will eventually lock up making you reset the machine.... I can go on, but I find it a complete waste of time and effort, it may be okay in Marlin, but not for RepRap.

Wombat37, 2021-04-30:
What a miserable email!

If it doesn't work, throw it out! What a message!

Did you ever wonder why things often get better?

I assume that you still live in a cave.

Wombat37, 2021-09-20:
Issue moved to

[https://github.com/bigtreetech/BIGTREETECH-TouchScreenFirmware/issues/1856](url)

It's still open but doesn't belong here.

Closing out...

Closed 2021-09-20.

Thread 10 (2021-04-19):

Schematic for BTT-E3-RRF V1.1?

kingjamez, 2021-04-19:
I'm trying to trouble shoot the fans on my BTT-E3-RRF V1.1 not working and I suspect that the pin mapping is not correct in the firmware. I need the schematic to know which pins to setup for the fans PWM output.

jaysuk, 2021-04-19:
I can confirm that fan0 is PB5 and fan1 is PB6

kingjamez, 2021-04-19:
> I can confirm that fan0 is PB5 and fan1 is PB6

Oh wow, thanks for the response Jay!  Well I guess I can take that with authority then...
I hate to use you as BTT tech support, but while I have you. Is there any reason short of hardware failure on a brand new board that this wouldn't activate my fans and bed?
From my RRF config:

; Fans
M950 F0 C"fan0" Q1000                          ; create fan 0 on pin fan0 and set its frequency
M106 P0 S1                                               ;set fan 1 value.
M950 F1 C"fan1" Q1000                          ; create fan 1 on pin fan1 and set its frequency
M106 P1 S1                                               ; set fan 1 value.

M308 S0 P"bedtemp" Y"thermistor" T100000 B3950 ; configure sensor 0 as thermistor on pin bedtemp
M950 H0 C"bed" T0                              ; create bed heater output on bed and map it to sensor 0
M301 P21.73 I1.54 D76.55                       ; disable bang-bang mode for the bed heater and set PWM limit
M307 H0 R2 D65 B1 S1.00                        ; disable bang-bang mode for the bed heater and set PWM limit
M140 H0                                        ; map heated bed to heater 0
M143 H0 S150                                   ; set temperature limit for heater 0 to 150C

Fan 1 seems to be stuck on at roughly PWM of 75%, Fan 0 never activates, and my Bed never starts heating, even when running a M303 calibrate routine.

My hotend, perplexingly, works just fine on H1.

-Jim

jaysuk, 2021-04-19:
can you also post your tool line from your config.g file? should be the line with M563
you fan settings do look wrong though.
which fan is which?

kingjamez, 2021-04-19:
> can you also post your tool line from your config.g file? should be the line with M563
> you fan settings do look wrong though.
> which fan is which?

Those settings are the last configuration from my ~4 hours of testing last night... not stock. There are just designed to make the fans turn. I have a Duet on my big delta and would try settings there before bringing them over to RRF on the Ender 3.

My current tool settings:
; Tools
M563 P0 D0 H1                                ; define tool 0
G10 P0 X0 Y0 Z0                                ; set tool 0 axis offsets
G10 P0 R0 S0                                   ; set initial tool 0 active and standby temperatures to 0C

I tried it stock from the github and currently have it with no fan defined for Tool 0 ( I deleted F0 from the M563 line). But I only did that after it didn't work. Note that this tool is working very well... it's the only PWM device working :-).

I have Fan0 on the Hotend fan, Fan1 on the tool fan (part cooling). Both fans are tested and work when directly connected to the power supply.

Thank you for the help! I'm pulling my hair out!

jaysuk, 2021-04-19:
this should work for you
```
; Fans
M950 F0 C"fan0" Q500                           	; create fan 0 on pin fan0 and set its frequency
M106 P0 S0 H-1                                 	; set fan 0 value. Thermostatic control is turned off
M950 F1 C"fan1" Q500                         	; create fan 1 on pin out4 and set its frequency
M106 P1 S1 H1 T45                            	; set fan 1 value. Thermostatic control is turned on

; Tools
M563 P0 D0 H1 F0                               	; define tool 0
```

jaysuk, 2021-04-19:
if it doesn't work, just on discord and we'll go through a few things
https://discord.gg/uS97Qs7

kingjamez, 2021-04-19:
Awesome, will do, thank you!

GadgetAngel, 2021-05-21:
I need to see the schematic so that I can hook up a MAX31865 fir PT100 sensor. I need to see which pins on the board have pull-up resistors and which pins are on SPI bus 1 or SPI bus 2 or SPI bus 3. This is the purpose of the schematic to help users attach additional equipment. Please provide the schematic

trengtor, 2021-05-22:
Please upload schematics files. It needs for non-standart printers.

thisiskeithb, 2023-05-03:
Added: https://github.com/bigtreetech/BTT-E3-RRF/blob/master/BTT%20E3%20RRF%20V1.1/Hardware/BTT%20E3%20RRF%20V1.1-SCH.pdf

Thread 11 (2021-04-21):

Temperature fail installing on ender 3

Suco1234, 2021-04-21:
I have installed the board correctly on ender 3, but when i print a code, the upper side falls into the fill. i have done the next tests:

-I have already adjusted the feets/mm on extruder.
-It seems to be a temperature problem, it looks like the nozzle is warmer than the LCD says, so I changed the thermistor with a new one and configured correctly on marlin. (the resistor value seems to be correct based on the thermistor table)
Thermistor is NTC 100k at 25, beta 3950, sensor 11 on marlin config.
- The problem appears when I print PLA at 200ºC and 20% fill. The upper side improves when i print at 190ºC.

The same Gcode with the original ender 3 board and stock firmware looked great, so i discard a problem with slicer.
The next test i am going to do is to heat water to 100ºC and check the thermistor resistor value.
what else can i do?

Thread 12 (2021-04-25):

Nice to have better temperature calibration.

Wombat37, 2021-04-25:
I recently changed my Ender 3 V1.1.4 (8-bit) board to a new BTT-E3-RRF (32-bit) board with E3-TFT35 display running under RepRap.

I've had a few teething problems but all have been mainly addressed and I'm starting to like the new board and the RRF control a lot!

One major problem I experienced was that the print quality with the new board was awful and there were strange tapping noises coming from the hot-end and there were a lot of under-extrusion issues. Further investigation revealed that the hot-end temperature was about 24°C below the 220°C set point!!!

These temperature measurements were taken using thin thermocouple probes pushed through the hot-end and into the nozzle and confirmed on two meters.

Clearly, my system was badly in need of temperature recalibration. The 'official' instructions I read online to calibrate the hot-end thermistor were a bit vague and involved the removal of the thermistor and measuring its resistance when submerged in an ice bath and in boiling water. This is neither practical nor particularly accurate if the hot-end operating temperature is going to be normally in the range 190°C to 250°C.

There must be an easier way of fixing the temperature calibration on a system like mine when the error is as large as 24°C.

I managed to recalibrate my hot-end temperature in about 15 minutes without removing the thermistor from the system using the following process.

1. With the hot-end off and at ambient temperature, enter the code M308 S1 into the terminal on the TFT35 or via the DWC
2. The system will report the current temperature calibration settings for the hot-end. Note these down (you may need to return to them)
3. Successively enter M303 S1 Txxxxxxx with different values for the T parameter around 100,000 until the correct ambient temperature is reported on the TFT or DWC display. Don't adjust this unless there's a significant error.
4. Set the hot-end temperature to a typical operating temperature (e.g. 220°C)
5. Remove the PTFE tube from the hot-end
6. Push a thin thermocouple probe down through the hot-end and into the nozzle
7. Monitor the temperature of the nozzle on the thermometer connected to this thermocouple
8. Successively enter M303 S1 Bxxxx with different values for the B parameter around 4,000 until the hot-end temperature reading on the thermometer is about the same as the setpoint (within 1 or 2 °C). Turn off the hot-end heater before the M303 entry to prevent control errors and turn it back on afterwards and allow the temperature to stabilize before taking a reading. The previous value for the B parameter on my system was 3950 and I had to adjust it to 4325 to eliminate the 24°C error.
9. Note the new values for the T and B parameters and edit the M303 entry in the config.g file in the sys folder on the SD card to reflect these - e.g. M308 S1 P"e0temp" Y"thermistor" T100000 B4325
10. Remove the thermocouple and re-insert the PTFE bowden tubing

Note that this process is not calibrating the temperature of the thermistor, but rather ensuring that the nozzle temperature is reasonably correct - which is of course much more important.

I've used a similar process to calibrate the hot-bed temperature - the probe is taped to the surface of the bed.

The reason I'm posting this procedure here is that I feel that a new calibration procedure could be incorporated into the system - this is not a bug but a nice-to-have. I was manually adjusting the values for the T and B parameters but this process could be automated by software.

Alternatively, we could derive a new equation based on the predicted thermistor profile and the temperature gradient between the thermistor and the nozzle. We could then just enter two (or maybe three) temperature readings to calibrate the hot-end in situ.

Anybody else have any thoughts on this?

P.S. This information may be relevant to the poster of Issue #11

bovoro, 2021-08-06:
Hi Wombat37, that just happened to me, I replaced the thermistor and the ceramic cartridge, and above 200C with a thermocouple it throws me -20C, I have a doubt, in step 3, 8 and 9, you write Successively enter M303 S1 Txxxxxxx with different values for the T parameter, didn't you mean M308? I'm also running Reprap. PD. I saw a video "Marlin Thermistor Calibration (not PID tune)" https://www.youtube.com/watch?v=brl1weuD8bs and calibrates the thermistor in marlin, but it is more laborious and I don't know how we could replicate it in reprap firmware

Wombat37, 2021-08-06:
Hi Bovoro -

Yes you're quite correct. I did mean M308! I'd been using M303 all evening trying to debug the PID tuning on the TFT35 and must have somehow got it fixated.

After further thought on this topic, now RepRap supports variables and some limited programmability in macros, I think I can put together a macro to perform this sensor temperature calibration by guiding the user stepwise to take temperature measurements with an independent probe and somehow perform the necessary curve fit on the data. Not sure how to enter values into RepRap macros but everything else looks straightforward.

Wombat37, 2021-08-06:
Think I've worked out how to do all this without needing values to be entered. I'll look into it over the next few days.

bovoro, 2021-08-06:
Yes, I'm keeping an eye on https://duet3d.dozuki.com/Wiki/Calibrating_thermistor_and_PT1000_readings , but Semi-automatic calibration doesnt supported by our board , but at the bottom of that wiki , I had the idea of, select 220C on the screen, and with a thermocouple and multimeter, measure the real temperature, and go sending M308 Snn Lvvv for various values of vvv until I find the value that gives a reading close to the expected value that i setup

Wombat37, 2021-08-06:
My idea would be to have the user manually adjust the hotend temperature control until the thermocouple probe temperature inside the nozzle matches a given fixed temperature. The system will now know the temperature error at that setting. This process could be repeated at 1 or 2 more set temperatures so that we have 2 or 3 temperature error readings across the operational range. Now we can curve fit the expected thermistor profile to the adjusted temperature readings and calculate the coefficients to enter in the M308 statement. I think this could be driven from a RepRap macro.

bovoro, 2021-08-06:
thats sounds great!!. That is beyond my knowledge, I will try to investigate the macros as well,So,  this fixing that you raised at the beginning, can it be used to print as a temporary fix? I guess as long as I don't get too far up or down from the temperature I set to the beta value, right?

Wombat37, 2021-08-06:
The Steinhart–Hart equation used to characterize thermistor R vs T profiles has 3 coefficients although the c coefficient is usually set to zero. To calibrate the other two coefficients you will need at least three data points. The way you suggested might work at the temperature you calibrated it at but may give you a big error if you change that temperature.

bovoro, 2021-08-06:
I was just reading about Steinhart and Hart Equation , thats the key!!!!

bovoro, 2021-08-06:
Hi Wombat37, in flashed today Marlin FW, and the difference of temperature above 200C its only -5C is better than -25C with RRF, I could not compile with VSC, because it gives me error after error after error, I used the precompiled one. do you think it is a failure of poor quality thermistors or firmware configuration issue?  in both Marlin and RRF. with stock one thermistor they works great

bovoro, 2021-08-07:
Wombat37, with datasheet of my 100k b3950 , the datasheet has a table of temperature and resistance, with a calculator https://www.thinksrs.com/downloads/programs/Therm%20Calc/NTCCalibrator/NTCcalculator.htm I calculated the coefficient C steinhart, which apparently should be put in M308 S1 P "e0temp" Y "thermistor" T100000 B4725 C7.06e-8 (it is only an example) in the value of C you put what you get in the calculator in the coefficient C, right now I am printing with marlin, if the print is a hit or miss, I'll test my theory with RepRap Firmware.

Wombat37, 2021-08-07:
Hi Bovoro. I'll work on this later this week. I don't think we should be using this site as a forum so we should perhaps limit our postings. I will try to put together a working system that could be adopted or adapted in the RRF builds

Wombat37, 2021-09-20:
Hi Bovoro (and anyone else who may be interested),

I've looked into this matter of calibrating the temperature of a hot end thermistor and believe that I've come up with a novel solution that easy, cheap, accurate, doesn't need an expensive thermometer, will work with any printer and doesn't require any disassembly or modification.

I'm not sure how to get these files to you.

Perhaps BTT would be interested in picking this idea up as a potential product?

Wombat37, 2021-09-20:
This request is not appropriate to this repository.

I am still working on this but will close this out.

Closed 2021-09-20.

Thread 13 (2021-05-01):

DWC displays wrong print layers and heights

Wombat37, 2021-05-01:
I'm getting a bit cautious about entering more issues but I think this one is clearly wrong and should be working properly.

I'm running a BTT-E3_RRF v1.1 board with a BTT-E3-TFT35 v3.0 under RepRap 3.2.2. When I use the DWC to upload and run a print, I see strange and conflicting information on the print height and layer statistics.

See the annotated DWC screen capture below of an active print generated by Cura 4.9.0 and uploaded and run by DWC.

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

When this screen capture was taken, the print was currently at layer 84 - which was correctly reflected in one position of the display. The running chart showing layer timings showed that it was at layer 40 and this value was actively being updated.

Finally, the displayed print total height was displayed as 10mm with 50 layers - these values seemed to be displayed for anything being printed.

Clearly, there's misinformation here.

Wombat37, 2021-09-20:
Tidying up!

Now I understand BTT's position of offering boards that support firmware like RepRap available from other developers, it's inappropriate to expect them to make fixes to that software.

When I bought this board, I thought I was buying a complete product - not just part of it :)

Closing this out, now...

Closed 2021-09-20.

Thread 14 (2021-05-01):

DWC doesn't update charts when browser screen is not active and inserts false data when it's reactivated

Wombat37, 2021-05-01:
Here's another issue regarding the DWC display on my BTT E3 RRF v1.1 board with BTT E3 TFT35 v3.0 running RepRap 3.2.2.

In this case, my concern relates to the real time plots while the viewing browser (Google Chrome in this case) is not active - either I view another screen or the PC display times out.

The figure below is the same screen capture I posted in Issue# 13.

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

In the case of the temperature plots, it can be seen that the historical data is lost - which is better than inserting false data but it would be good to see all the temperature data since the print started.

In the case of the layer time, the plot just seems to insert whatever the value was for last layer and then when the browser is restored, there's a huge temporary jump in the displayed value - over 2 hours in this case - which is certainly erroneous.

Wombat37, 2021-09-20:
Tidying up!

Now I understand BTT's position of offering boards that support firmware like RepRap available from other developers, it's inappropriate to expect them to make fixes to that software.

When I bought this board, I thought I was buying a complete product - not just part of it :)

Closing this out, now...

Closed 2021-09-20.

Thread 16 (2021-05-16):

other printers

milicigoran, 2021-05-16:
will this work on biqu b1 or artillery sidewinder if i compile the firmware?

jaysuk, 2021-05-16:
Yes. It'll work on any printer that needs 4 drivers

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

milicigoran, 2021-05-16:
> Yes. It'll work on any printer that needs 4 drivers
> […](#)
> On Sun, May 16, 2021, 6:53 AM Goran Milici ***@***.***> wrote: will this work on biqu b1 or artillery sidewinder if i compile the firmware? — You are receiving this because you are subscribed to this thread. Reply to this email directly, view it on GitHub <#16>, or unsubscribe <https://github.com/notifications/unsubscribe-auth/AATUSBU3LZK7MWDGLV3UH5DTN5MXFANCNFSM446TW3QQ> .

THANK YOU. which one is the file that has the pin numbers so i can define in rff which ones im using for sensor less homing

jaysuk, 2021-05-16:
Here you go.
https://teamgloomy.github.io/skr_rrf_e3_pins.html

On Sun, May 16, 2021, 11:35 AM Goran Milici ***@***.***>
wrote:

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

Thread 17 (2021-05-17):

RRF and IDEX 1.1

Currents132, 2021-05-17:
I recently received the idex upgrade kit and I assembled it on my ender 3 pro and got everything wired up and loaded the new RepRap support files but the new idex 1.0 board isn't lighting up green and no command work and on the main RRF 1.1 board the 3.3v red led is flashing I have tried using the jumper on the idex board and the DuPont connector from the main board to the idex board and both methods don't work.

Currents132, 2021-05-18:
also my thermistor isn't getting a reading so the value given is -99

Thurnock, 2021-07-12:
So with this add on board you need to go into the marlin/src/pins/stm32f4/BTT rrf E3/ and need to turn on the IDEX board on. it will not work until you do. And also make sure the board is powered with its own 12-24Vdc.

Thread 18 (2021-05-18):

DIFFERENT DISPLAY

milicigoran, 2021-05-18:
Why does marlin throw out a bunch of dictionary errors whenever i change the screen to something else besides what was already chosen when i downloaded the marlin file. It basically gives me about 200 words it says it doesnt know and i have to add them to dictionary one by one or change the screen back. i wanted to change the screen to btt tft35 or 70 but couldnt. had to uncomment out cr10 display

Thread 19 (2021-05-28):

BTT-E3-RRF V1.1 it possible to use D-B500F laser modul with RepRap?

Zoli-user, 2021-05-28:
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

Hello, My question is very simple. How to connect and how to configure the Creality Ender 3 V2 with BTT-E3-RRF V1.1 to use this laser modul.
I use the latest RepRap firmware and BTT-E3-TFT35. Thank You.

Kung-Foo-Kamel, 2021-11-19:
Not sure about your specific laser module, but most have 4 wires, 12v input for powering the actual laser and a 12v PWM control wires to adjust the level of brightness.

You can configure one of the fan headers to run the PWM control wires and feed the laser module directly with power from your powersupply, if you are using a 24v system and the laser module is 12v, then just power the module from a separate 12v power supply and you can still use the fan header to control the PWN signal, but just set the maximum to 50%, that way your only feeding it 12v max.

So the answer is yes, but you will need to customise the config file to suit the tool your using, I'm actually doing this at the moment, you need to have 2 separate SDcard setups, and swap the card when swapping the tool.

I would be cautious about power your laser module directly from the fan header, you must check the total power required for you specific laser module and make sure the fan header can deliver that power, as the fan PWM outputs on this board can be easily fried, I have a couple here that went poopy in their pants from damaged wiring and faulty cheap fans.

jaysuk, 2021-11-19:
No need to have different SD cards.
Just use M505 https://duet3d.dozuki.com/Wiki/M505

Thanks,

Jay

On Fri, 19 Nov 2021 at 22:14, Kung-Foo-Kamel ***@***.***>
wrote:

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

Kung-Foo-Kamel, 2021-11-21:
Thanks for the info Jay, that's brilliant, this will make things much easier.

Thread 20 (2021-06-05):

IDEX board and PT100

sllo13, 2021-06-05:
How to I configure reprap to use a PT100 thermistor with the IDEX board
how to I set the thermistor in the config.g file?
Searched everywhere and havent found an answer

Ragpuss, 2022-01-14:
I would like to know the same thing.
Did you manage to find any answers ?
Also should the heater plug into the IDEX board if using a PT100 on the same board ?
It's strange that there's still no info for this !!

chef79, 2022-01-29:
would love some info about this to

Ragpuss, 2022-01-29:
It looks to me like BTT have combined their PT100 daughter board into the IDEX so if thats the case it should be a setting of 20 for the sensor, I am still not sure on the pin.h file if it will automatically push the connection to the IDEX board like it does for the 2nd Z stepper or if the correct pin assignment has to be put somewhere.

chef79, 2022-01-29:
yes there is pt100 chip on the idex,  but what table do one use to get correct readings.
lowered resistance to 1400 and got 23C  heated the sensor to 60c and temp dropped to 16c hehe.

chef79, 2022-01-29:
heat.tempSensePins = {bedtemp,PT100};
you got this in board.txt?  i needed to change E0 to PT100 to get it working

Ragpuss, 2022-01-29:
Isn't E0 the hot end heater ? , it would need to be the thermistor to change.
I haven't changed any pin assignments yet as it's not something that I have messed with much in the past and don't wont to blow my printer up, lol.
Did you have it set to 20 when you got those odd readings. If the IDEX is using 3.3v instead of 5v it might need to be 21
I noticed a jumper that's marked as 3.3v with a jumper cap on it, not sure if that's for the PT100 or not.

marcoeli007, 2023-01-04:
Define in the file "pins_BTT_E3_RRF.h" TEMP_0_PIN to FPC8_PIN. Disable PA0
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

Set in "Configuration.h" TEMP_SENSOR_0 to 20
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

Thread 21 (2021-06-11):

Printer reboots when printing from sd card

asipek1, 2021-06-11:
When printing from sd card printer (Ender 3) reboots after few layers, but when using pronterface that issue is not present. Firmware is Marlin bugfix 2.0.7.2.x., board bigtreetech e3 rrf v1.1.

bovoro, 2021-08-06:
I have the same issue, do you have the web gui configured? its like pronterface wireless, but when i send a command doesnt do anything

asipek1, 2021-08-07:
No I dont have, I resolved my issue by installing new firmware.

randomailer, 2023-04-03:
Hey, I have the same problem. Which firmware did you install?

asipek1, 2023-04-03:
Depends what ender 3 you have, I installed this https://github.com/asipek1/Ender3_BTT_E3_RRF_Marlin/tree/main/3dtouch
Mine is with stock display, 3D touch sensor and e3 rrf motherboard.

randomailer, 2023-04-11:
Thanks,

It fixed my problem

Thread 22 (2021-06-26):

Unable to compile for my SV01

AllTheCommotion, 2021-06-26:
Followed a compile video on YouTube for the RRF board for the Sovol SV01. Seemed pretty easy, but it will not compile. Tried probably 10 times, and every build failed. The video is from Aurora Tech on YouTube. I am trying to compile it to use the IDEX board as well to be used as a controller for the second Z motor for Z auto align. Any help would be greatly appreciated. I also will be using a BLtouch.

> Executing task: C:\Users\pulle\.platformio\penv\Scripts\platformio.exe run --environment BIGTREE_E3_RRF <

Processing BIGTREE_E3_RRF (platform: ststm32@~12.0; board: BigTree_E3_RRF; framework: arduino)
---------------------------------------------------------------------------------------------------------------------------------------------------------------------------------------------------------------------------------Verbose mode can be enabled via `-v, --verbose` option
arm-none-eabi-g++.exe: fatal error: cannot execute 'cc1plus': CreateProcess: No such file or directory
compilation terminated.
CalledProcessError: Command '"C:\Users\pulle\.platformio\packages\toolchain-gccarmnoneeabi\bin\arm-none-eabi-g++.exe" -D__MARLIN_FIRMWARE__ -DUSBCON -DUSBD_USE_CDC -DTIM_IRQ_PRIO=13 -DADC_RESOLUTION=12 -DSTM32F407_5VX -DVECT_TAB_OFFSET=0x8000 -DSERIAL_RX_BUFFER_SIZE=255 -DSERIAL_TX_BUFFER_SIZE=255 -D__MARLIN_DEPS__ -w -dM -E -x c++ buildroot/share/PlatformIO/scripts/common-dependencies.h' returned non-zero exit status 1.:
  File "C:\Users\pulle\.platformio\penv\Lib\site-packages\platformio\builder\main.py", line 175:
    env.SConscript(item, exports="env")
  File "C:\Users\pulle\.platformio\packages\tool-scons\scons-local-4.1.0\SCons\Script\SConscript.py", line 591:
    return _SConscript(self.fs, *files, **subst_kw)
  File "C:\Users\pulle\.platformio\packages\tool-scons\scons-local-4.1.0\SCons\Script\SConscript.py", line 280:
    exec(compile(scriptdata, scriptname, 'exec'), call_stack[-1].globals)
  File "C:\Users\pulle\Desktop\Marlin-2.0.7.2.x-E3-RRF\buildroot\share\PlatformIO\scripts\common-dependencies.py", line 321:
    apply_features_config()
  File "C:\Users\pulle\Desktop\Marlin-2.0.7.2.x-E3-RRF\buildroot\share\PlatformIO\scripts\common-dependencies.py", line 146:
    if not env.MarlinFeatureIsEnabled(feature):
  File "C:\Users\pulle\.platformio\packages\tool-scons\scons-local-4.1.0\SCons\Util.py", line 658:
    return self.method(*nargs, **kwargs)
  File "C:\Users\pulle\Desktop\Marlin-2.0.7.2.x-E3-RRF\buildroot\share\PlatformIO\scripts\common-dependencies.py", line 297:
    load_marlin_features()
  File "C:\Users\pulle\Desktop\Marlin-2.0.7.2.x-E3-RRF\buildroot\share\PlatformIO\scripts\common-dependencies.py", line 285:
    define_list = subprocess.check_output(cmd, shell=True).splitlines()
  File "C:\Users\pulle\.platformio\python3\lib\subprocess.py", line 424:
    return run(*popenargs, stdout=PIPE, timeout=timeout, check=True,
  File "C:\Users\pulle\.platformio\python3\lib\subprocess.py", line 528:
    raise CalledProcessError(retcode, process.args,
================================================================================================== [FAILED] Took 0.66 seconds ==================================================================================================

Environment     Status    Duration
--------------  --------  ------------
BIGTREE_E3_RRF  FAILED    00:00:00.664
============================================================================================= 1 failed, 0 succeeded in 00:00:00.664 =============================================================================================The terminal process "C:\Users\pulle\.platformio\penv\Scripts\platformio.exe 'run', '--environment', 'BIGTREE_E3_RRF'" terminated with exit code: 1.

Terminal will be reused by tasks, press any key to close it.

Thread 23 (2021-06-29):

Dual X carriage need to use XMAX plug ISSUE - marlin 2.0.9.1

So6Rallye, 2021-06-29:
hi, i've already compil marlin 2.0.8 with idex board and i don't have this issue but on marlin 2.0.9.1 i've this problem when define dual x carriage. i can't compil, see picture attached. Do you have explication for that ?

Thanks

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

muttstang, 2021-12-16:
I’m getting the same error. I’m trying the newer firmware to see if it fixes a temperature instability issue with my 2nd hotend but I get this error

trengtor, 2021-12-19:
Try 2.0.8.2

trengtor, 2021-12-19:
& ask it in main Marlin github ­- it will be right

Thread 24 (2021-07-11):

Buil ESP3D

VitisEK, 2021-07-11:
Hi,
I cannot build ESP3D firmware when I tried to follow the manual.
I get this error:
esp3d \ notifications_service.cpp: 38: 10: fatal error: WiFiClientSecureAxTLS.h: No such file or directory
Any suggestion?

trengtor, 2021-07-18:
Marlin?

iMechy, 2022-12-10:
you can build it on arduino webediter. I'm encountering the same issue on arduino ide 2.0.3

Thread 25 (2021-07-13):

Marlin out dated, to many errors

kastor159, 2021-07-13:
Can the Marlin FW please be updated.
I find eeprom saves are forgotten.
Z axis offset keeps changing as well.
bad BLtouch functionality.
I fi can install an alternative FW its fine as well.
Thanks

BobCraig10, 2021-08-06:
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

I have nothing to do with this besides owning one also. I planned on using it with reprap firmware, and really liked using it. I did find that using it with Marlin was just a little more "polished" and had some functionality that was more important to me. I was able to compile the newest Marlin 2.0.9x for the btt e3 rrf with no issues. The instructions  to compile are pretty much the same as what is listed to compile for 2.0.7x, just with different line numbers.   Something to look for, the newest Marlin build has provisions to assign 3 serial ports, so you can have the serial tft display, the USB , AND the wifi, so you can have ESP3D functionality  and tft display, and octoprint all work at the same time.  If you need help compiling it, I can try to help, but there may be others that know more about it than me.   If you go through all the Marlin options, there is some really neat features I knew nothing about, and glad I compiled everything myself.

trengtor, 2021-09-01:
> Can the Marlin FW please be updated.

https://github.com/MarlinFirmware/Marlin/issues

nevsdea2, 2022-01-04:
I've had the same problems as @kastor159 - forgotten saves and Z axis offset changes every time I do a print (I need to add the z-axis offset every time I start a print - 2 on the first print, then 4 on the second print, then 6 on the third print, then 8, and so on every time I do a print.

I noticed that 2.0.7.x was a bit old so also wanted to make a new build based off Marlin 2.0.9.2, hoping that using the newer Marlin might help.  I merge in the changes from configuration.h and configuration_adv.h but then it won't build.  It seems I need to add the BIGTREE_E3_RRF environment in the platformio.ini file, then it still won't build because it's missing a bunch of .json and .py files for the BTT and STM32F boards and other stuff.  So I copy those over from the BTT supplied 2.0.7.x build, and then it builds but the board won't boot up when I flash with this firmware.  I can switch back to the 2.0.7.x Ender3 Marlin build and it boots again, but back to the bad behaviours.

@BobCraig10 how did you get plain vanilla Marlin 2.0.9.x to work?  Maybe you could share your configuration files?  Did you need to modify platformio.ini?

Thread 27 (2021-11-07):

What's the best config option on marlin for BTT tft35v3.0 and BTT E3 RFF v1.1?

obionekenewbie, 2021-11-07:
Hi, i recently bought the BTT E3 RFF v1.1 to try the idex mode and the TFT35 V3.0 touchscreen updated to 0.27 but when i compile in VS code i cant choose REPRAP_DISCOUNT_FULL_GRAPHIC_SMART_CONTROLLER beacouse if i do i get this error:Only CR10_STOCKDISPLAY, ZONESTAR_LCD, ENDER2_STOCKDISPLAY, MKS_MINI_12864, and TFTGLCD_PANEL_(SPI|I2C) are currently supported on the BTT_E3_RRF. So can you tell me if this board and tft are compatible and in wich way i should set them to work fine? beacouse if i choose CR10_STOCKDISPLAY it "works" only in marlin mode but with a lot of screen bugs and in touch mode the tft says printer not attacked even if try changing the baudrate ( current settings: SERIAL_PORT 3, SERIAL_PORT_2 -1, BAUDRATE 115200.)
Thanks for attention.
Kind regards.

radek8, 2021-11-09:
For touch mode communication, you must connect the serial cable and set serial port 1
SERIAL_PORT 1

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

Blacksheep74, 2021-11-17:
OK I've had the same problem, and changing the serial port to 1 still gives me the same error.
Don't understand why this would be released if only compatible with so few LCD displays, and a few searches this is a very big problem with no known solution.

radek8, 2021-11-17:
What's your mistake?

trengtor, 2021-11-17:
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

All works fine!

Thread 28 (2021-11-18):

Measurements Missing From Board Size PDF

Kung-Foo-Kamel, 2021-11-18:
As title states, measurements missing from https://github.com/bigtreetech/BTT-E3-RRF/blob/master/BTT%20E3%20RRF%20V1.1/Hardware/BTT%20E3%20RRF%20V1.1-SIZE.pdf

Its impossible to get the exact mounting hole dimensions from this document, to reference a holes location, you must reference 2 measurements one on the X and one on the Y axis.

Also the 3D Step file has no holes referenced at all, so I can't use that for exact standoff locations.

Any chance someone at BTT can upload a more accurate dimension sheet.

Thread 29 (2021-11-18):

Component Schematics

Kung-Foo-Kamel, 2021-11-18:
Can BTT release basic component schematics for this board, as I have several with damaged PWM fan headers, and I would like to repair them.

GadgetAngel, 2022-02-23:
Where is the schematic for this board?

ellensp, 2023-04-12:
Also after the schematic

thisiskeithb, 2023-05-03:
Added: https://github.com/bigtreetech/BTT-E3-RRF/blob/master/BTT%20E3%20RRF%20V1.1/Hardware/BTT%20E3%20RRF%20V1.1-SCH.pdf

Thread 30 (2021-11-28):

E3 RRF IDEX 1.0 Fan0 Fan1 no power

Cowbite, 2021-11-28:
I'm getting no power to these fan headers - Fan0 and Fan1 on the idex board. Should they just work or do they need turning on in the firmware?
I'm currently using it for a second z axis on an Ender 3, so it's setup and working as far as that goes.

trengtor, 2021-12-28:
Neeg config in FW

Cowbite, 2022-01-01:
Problem wasn't with the board or firmware. Wiring issue.

Closed 2022-01-01.

Thread 31 (2021-12-30):

Hotend 2 on IDEX build will not settle on the desired temperature

muttstang, 2021-12-30:
I've been fighting this issue for months now on my diy IDEX build.  I have the BTT E3 RRF V1.1 along with the IDEX expansion board.  It oscillates +/- 15 degrees around the desired temperature.

I have changed out the wires, boards, heaters, thermistors.

I have run numerous PID tunes and tried manually changing the PID values with no success.

I have hooked up a multimeter and measured the voltage at the thermistor and it does not track well with what the display shows the temperature to be.  The voltage at the thermistor moves as it should, but the display will show the temperature jumping 10-12 degrees at a single screen refresh.

I've hooked an oscilloscope up to the thermistors on both hotends and they both give the same amount of noise at the thermistors.

In looking at the documentation, It appears like the raw thermistor data for the IDEX board is sent over the ribbon cable instead of being converted to a digital signal first so I wonder if it is picking up noise over the ribbon cable.

As I said, I've been trying to debug this issue for a few months and am extremely frustrated.  I can run my printer as a single extruder setup but not as the IDEX as intended.

Here are some links to video I took:

https://youtu.be/qX9mCo87HI8
https://youtu.be/sQQABGbAlfA

jaysuk, 2021-12-30:
Want to come and join us on discord and we can dig into this a bit more? https://discord.gg/uS97Qs7

muttstang, 2021-12-30:
The STM32 hardware support channel?  I'm waiting the obligatory 10 minutes from registration

Thanks
Eric

We must think outside the box! Ya got ta CHANGE the pairadigum! Jesse, step away from the box!

________________________________
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

trengtor, 2021-12-31:
Try to use ferrite EMI filter for ribbon cables

Zarrsito, 2023-01-15:
im having the same issue with jumping temps , would be nice if someone finds a working fix for this =)

Zarrsito, 2023-01-19:
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

looks like it gets in trouble when the heatbed gets activated... or disabled, ive tryed manually a bit around ending up with this..
any ideas? When the heatbed gets higher than 60C things normalize except jumping temps on extruder 2, my heatbet makes high tones too, since the upgrade when running on 60C, ive already tryed around with some magnets

Thread 32 (2022-03-11):

BL TOUCH not working on marlin

slowmosquito, 2022-03-11:
Hello

i have a bigtreetech e3 rrf installed on ender3

it works ok , also wifi works ok and all is very well

i installed a bltouch and enabled on firmware marlin the auto bed level.

When i give auto level command the pronter starts procedure but stops at first point

Attached a txt file with debug, i see the error no trigger

i definied this #define Z_MIN_PROBE_PIN 32 // Pin 32 is the RAMPS default

The bltouch probe is connected to Z PROBE 5 pin

i attach also configuration.h (on txt format) file

any suggestion aprecied

thanks
[debug.txt](https://github.com/bigtreetech/BTT-E3-RRF/files/8233613/debug.txt)
[Configurationh.txt](https://github.com/bigtreetech/BTT-E3-RRF/files/8233618/Configurationh.txt)

Thread 34 (2022-07-09):

FAN0 only runs on 100% , 99% wont start it on Marlin / Ender 3

Zarrsito, 2022-07-09:
Hello,

i dont know why but i cant control the Speed of the FAN0 for part Cooling, it only starts on 100% , 99% just make it stop...
on my old creality mainboard there was no problem, since i installed an fan with more power i only run it at 80% cause 100% makes noise :D well the Axis are now Quiet but my fan is noisy now xD any suggestions ??

trengtor, 2022-07-10:
It may depends from cooler model & PWM freq.

> i dont know why but i cant control the Speed of the FAN0 for part Cooling, it only starts on 100% , 99% just make it stop... on my old creality mainboard there was no problem, since i installed an fan with more power i only run it at 80% cause 100% makes noise :D well the Axis are now Quiet but my fan is noisy now xD any suggestions ??

Zarrsito, 2022-07-10:
Yeah u was right =) i needed to set it to 44000 to function properly, runs smooth now like a charm =)

Thread 35 (2022-12-26):

bootloader

mystone51, 2022-12-26:
Hi, i have a problem with my e3 rrf. i uploaded a marlin firmware, all is done, and i search now at update the firmware,but the motherboard dont accept it by usb, i think about bootloader is broken. is anyone know how to upload new bootloader,or help me,please ?

thanks so much

Thread 36 (2023-01-16):

BTT E3 RRF wifi v1.1 antenna specs/replacement

Olliftw, 2023-01-16:
When building the mainboard into a new case the original antenna wire got snapped of the sticker part. I tryed to resolder it but didnt work. Now im lost on finding a replacement one, due to lack of information on what the original antenna specs are. My wifi connection never was higher then -65db most of the time -70db ish. So i want to buy a better antenna but dont know what to look for.

thanks in advance!

Thread 38 (2023-03-28):

Help fixing FAN issue

engpedrorafael, 2023-03-28:
Hello,

I have a problem with the FAN0 and I would like to fix it, but there is no schematics of the board BTT-E3-RRF available.
I measured the input of the MOSFET controlling the FAN0 and instead of having a PWM signal with 5V sqared wave, I read a sqared wave of 1V.
I imagine that there may be a transistor, optocoupler or something similat between the GPIO of the CPU and the MOSFET broken causing the issue.
Can you please indicate if there is such an intermidiate component, where is it located and which is it so that I can fix the board?
Kind regards,

   Pedro Almeida

Thread 39 (2023-06-06):

Shorted heater, neopixels dead, other pins possible?

Olliftw, 2023-06-06:
So i have a adafruit neopixel ring around my hotend wich worked well untill i accidently shorted something while cleaning my hotend with a wirebrush, the neopixels went out, eventough the vccout still gave 5v i still swapped for a new neopixel ring, but also doesnt work. Is it possible to use other pins on the board? Im running latest version of reprap firmware with DWC

jaysuk, 2023-06-06:
Possibly. Best join us on discord so we can look at this in more detail
https://discord.gg/uS97Qs7

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
