bigtreetech/BTT-E3-RRF/BTT E3 RRF V1.1/Hardware/BTT E3 RRF V1.1-SCH.pdf

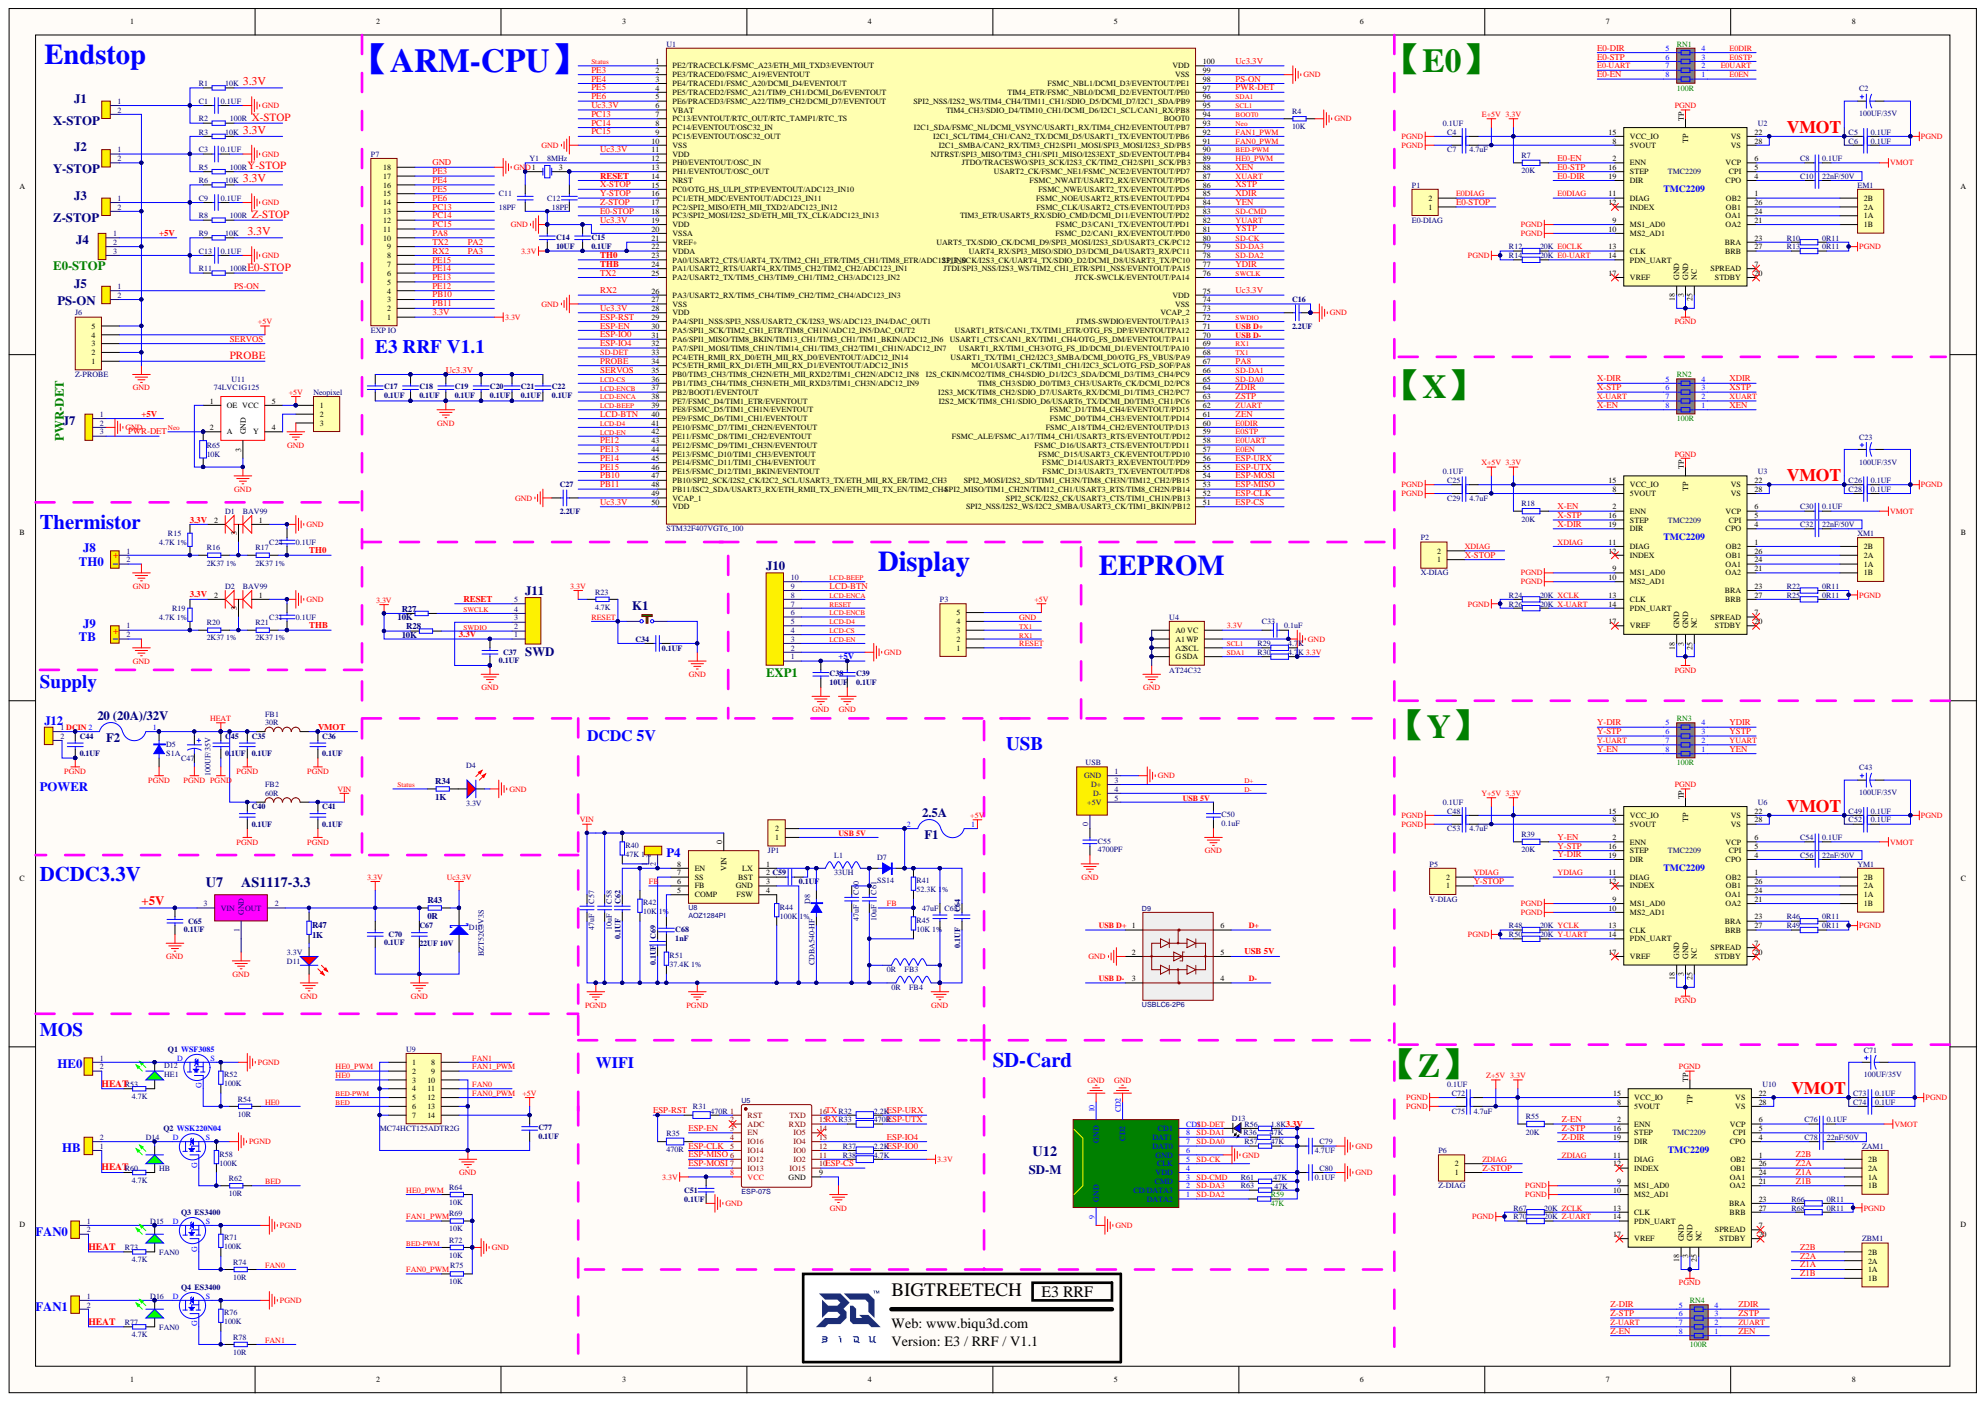
[picture p93: page 1]

E0STP
E0UART
ESP-URX
ESP-UTX
ESP-CS ESP-CLK ESP-MISO ESP-MOSI
