bigtreetech/BTT-E3-RRF/BTT E3 RRF V1.1/Hardware/BTT E3 RRF IDEX V1.0-pin.pdf

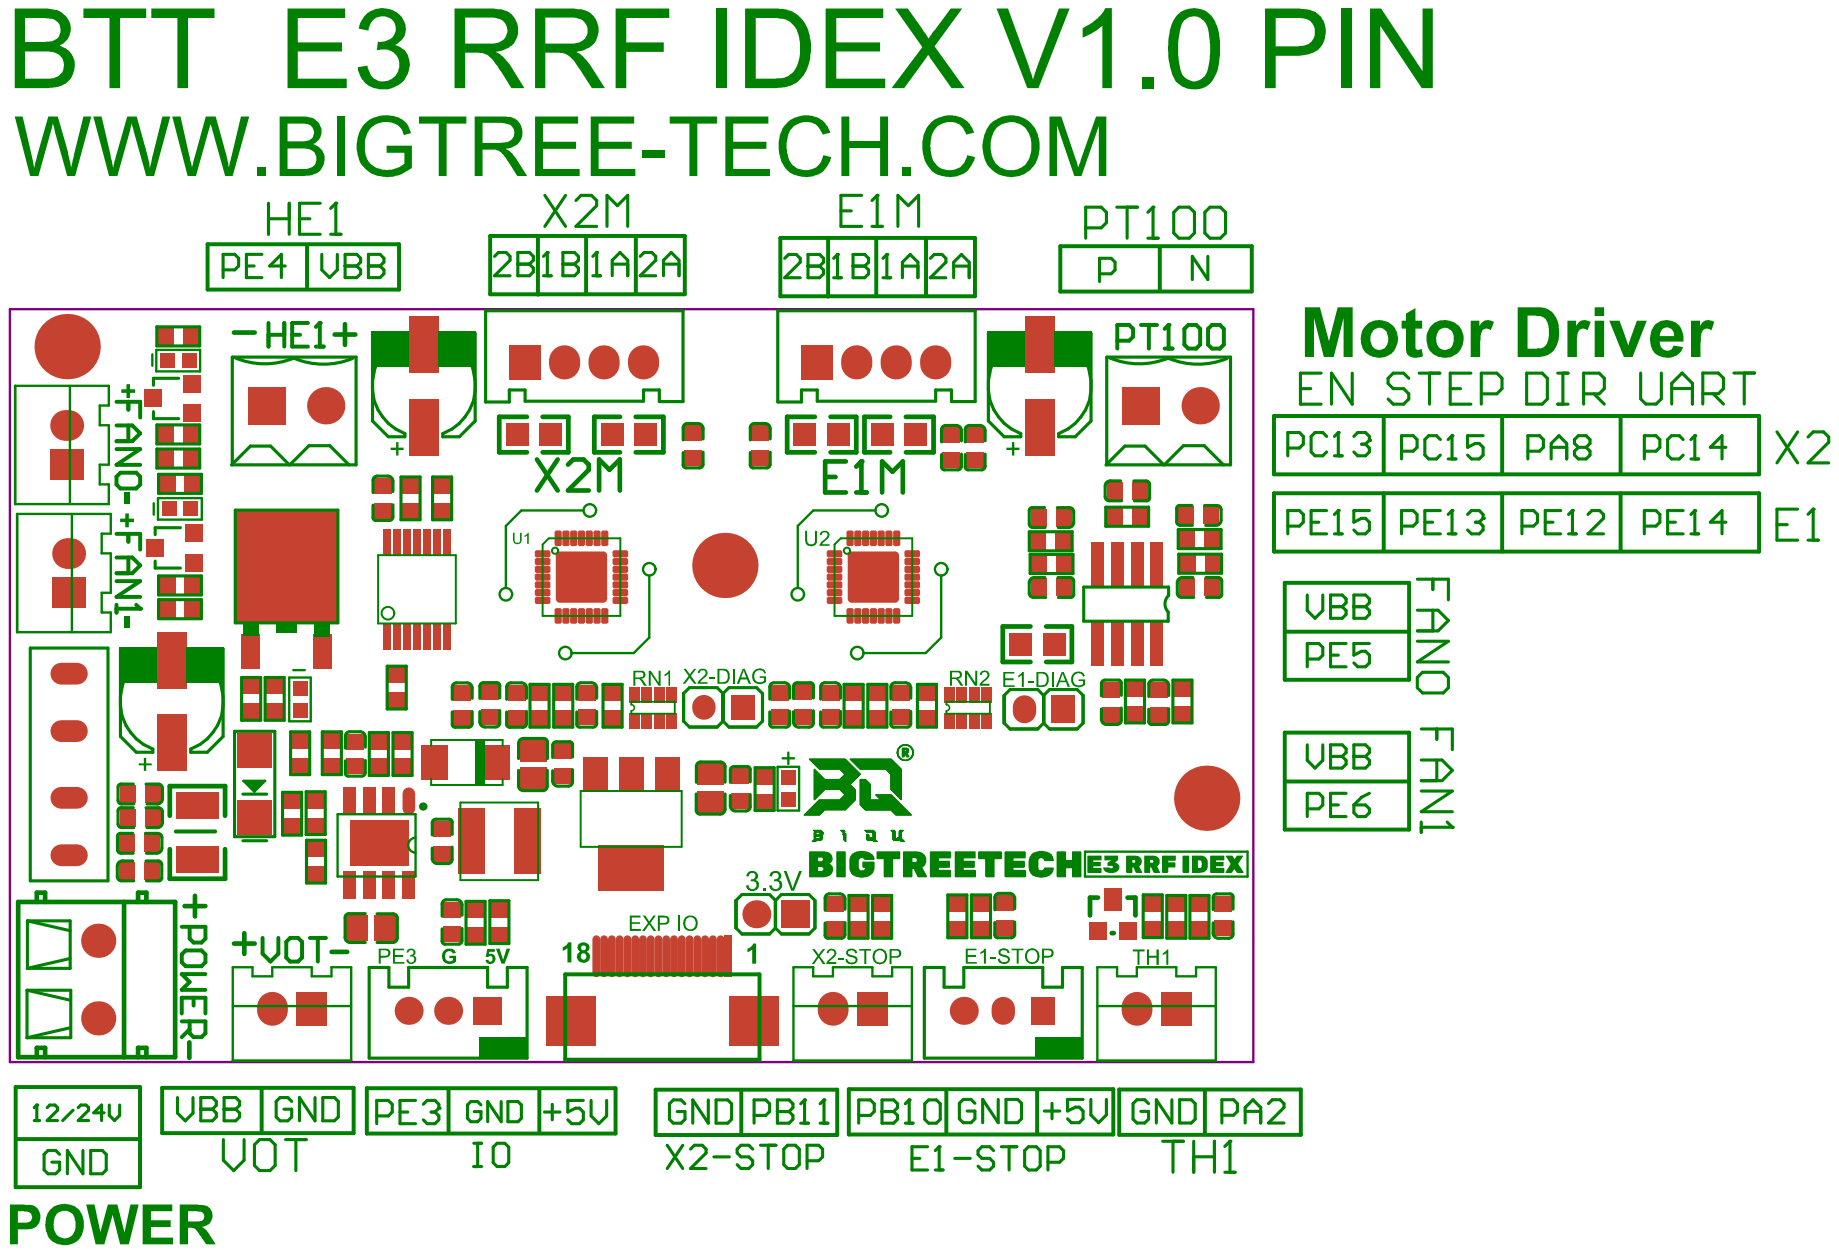
[picture p94: page 1]
