bigtreetech/BTT-E3-RRF/BTT E3 RRF V1.1/Hardware/BTT E3 RRF IDEX V1.0-top.pdf

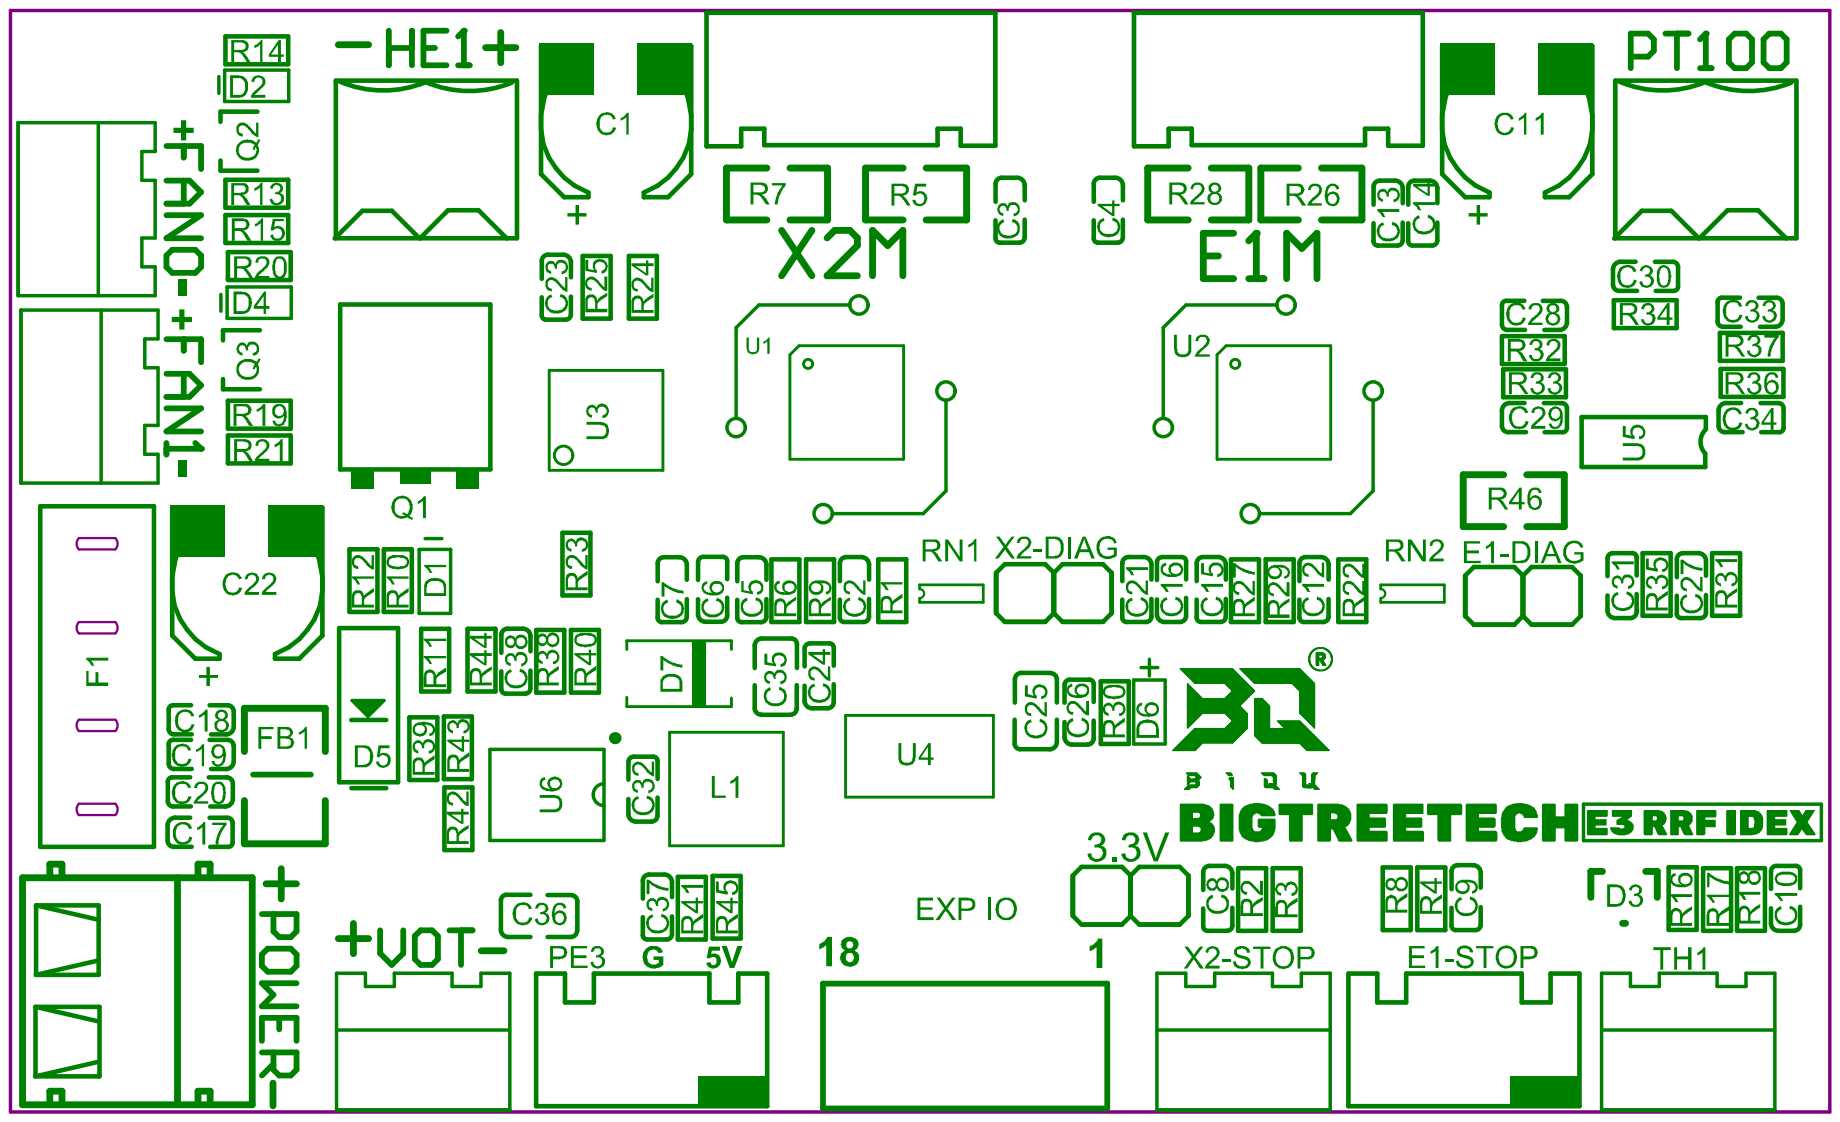
[picture p96: page 1]
