bigtreetech/BTT-E3-RRF/BTT E3 RRF V1.1/Hardware/BTT E3 RRF V1.1-PIN.pdf

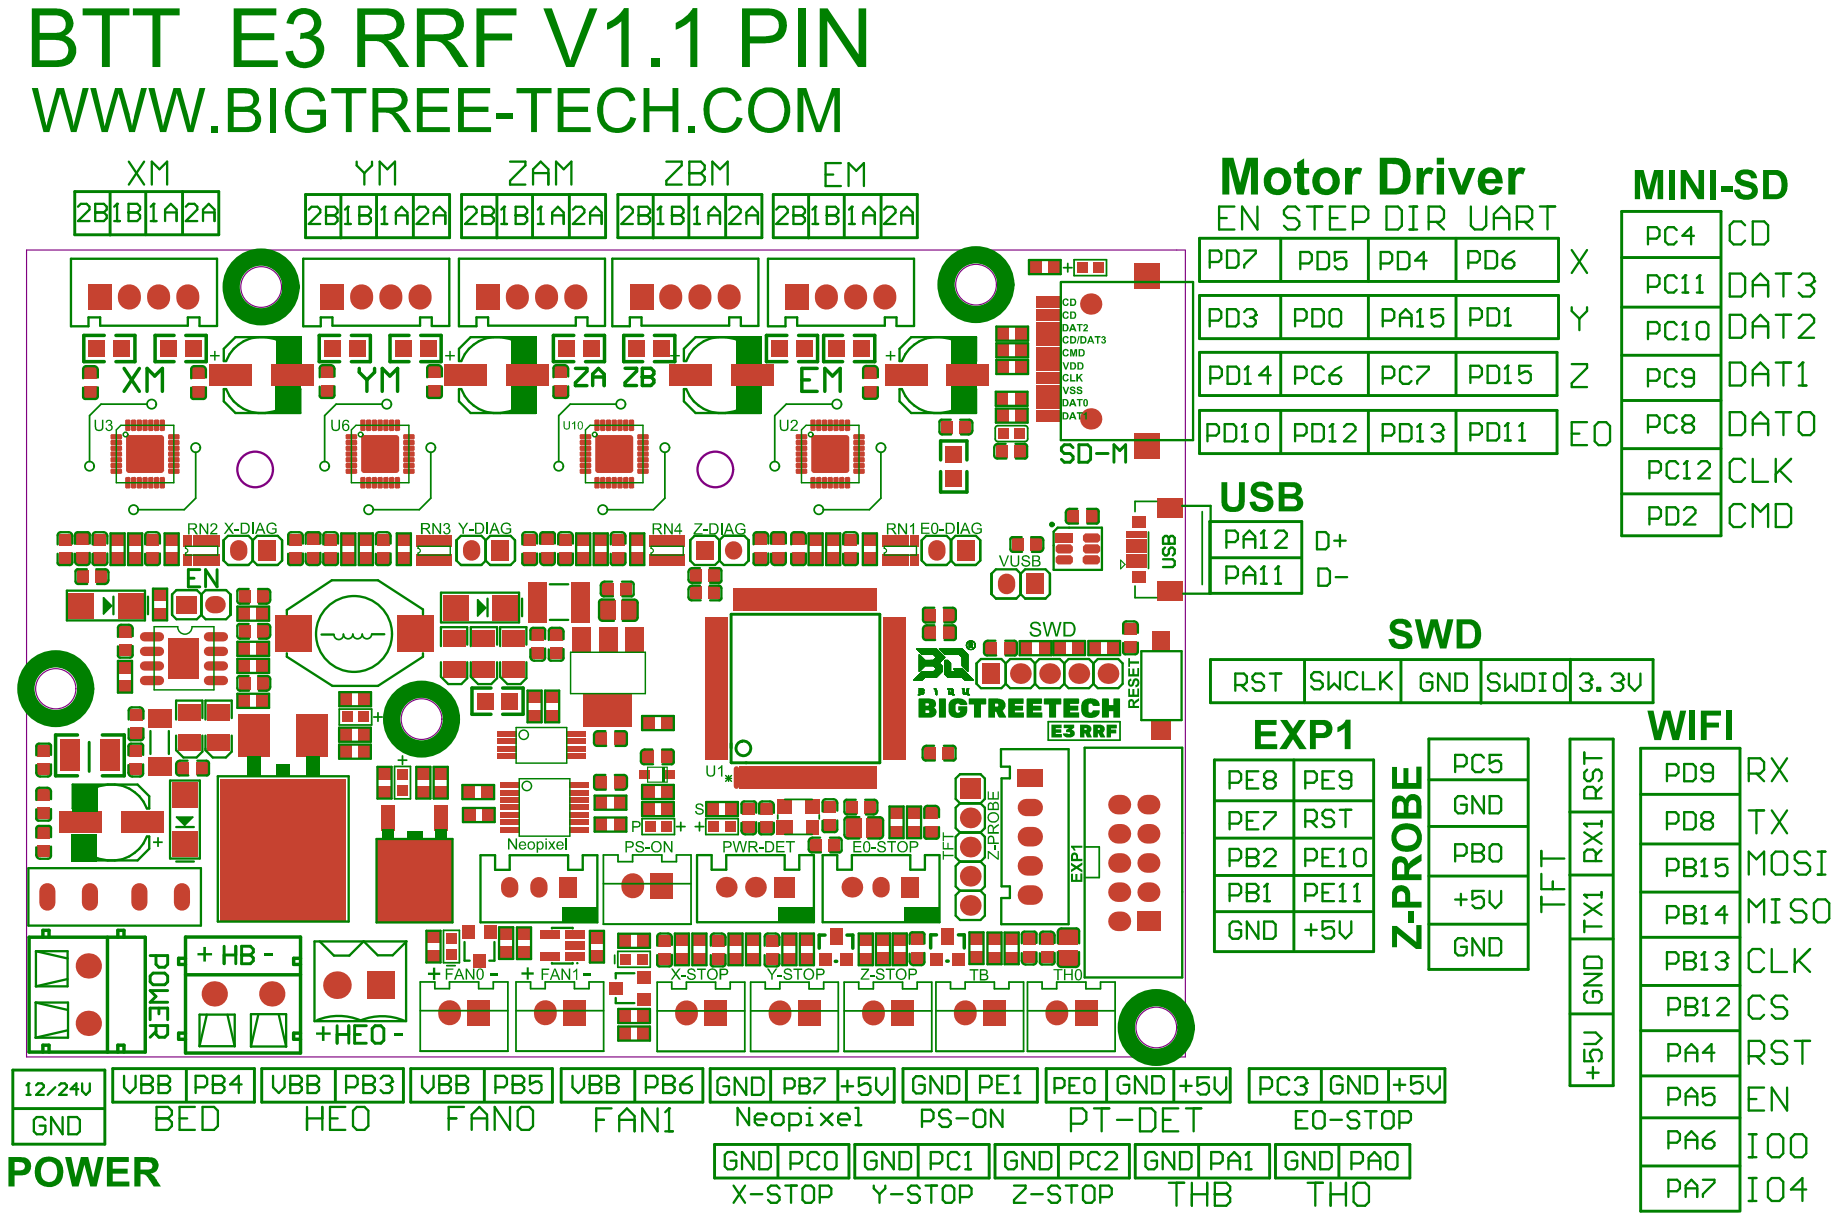
[picture p97: page 1]
