bigtreetech/BTT-E3-RRF/BTT E3 RRF V1.1/Hardware/BTT E3 RRF V1.1-SIZE.pdf

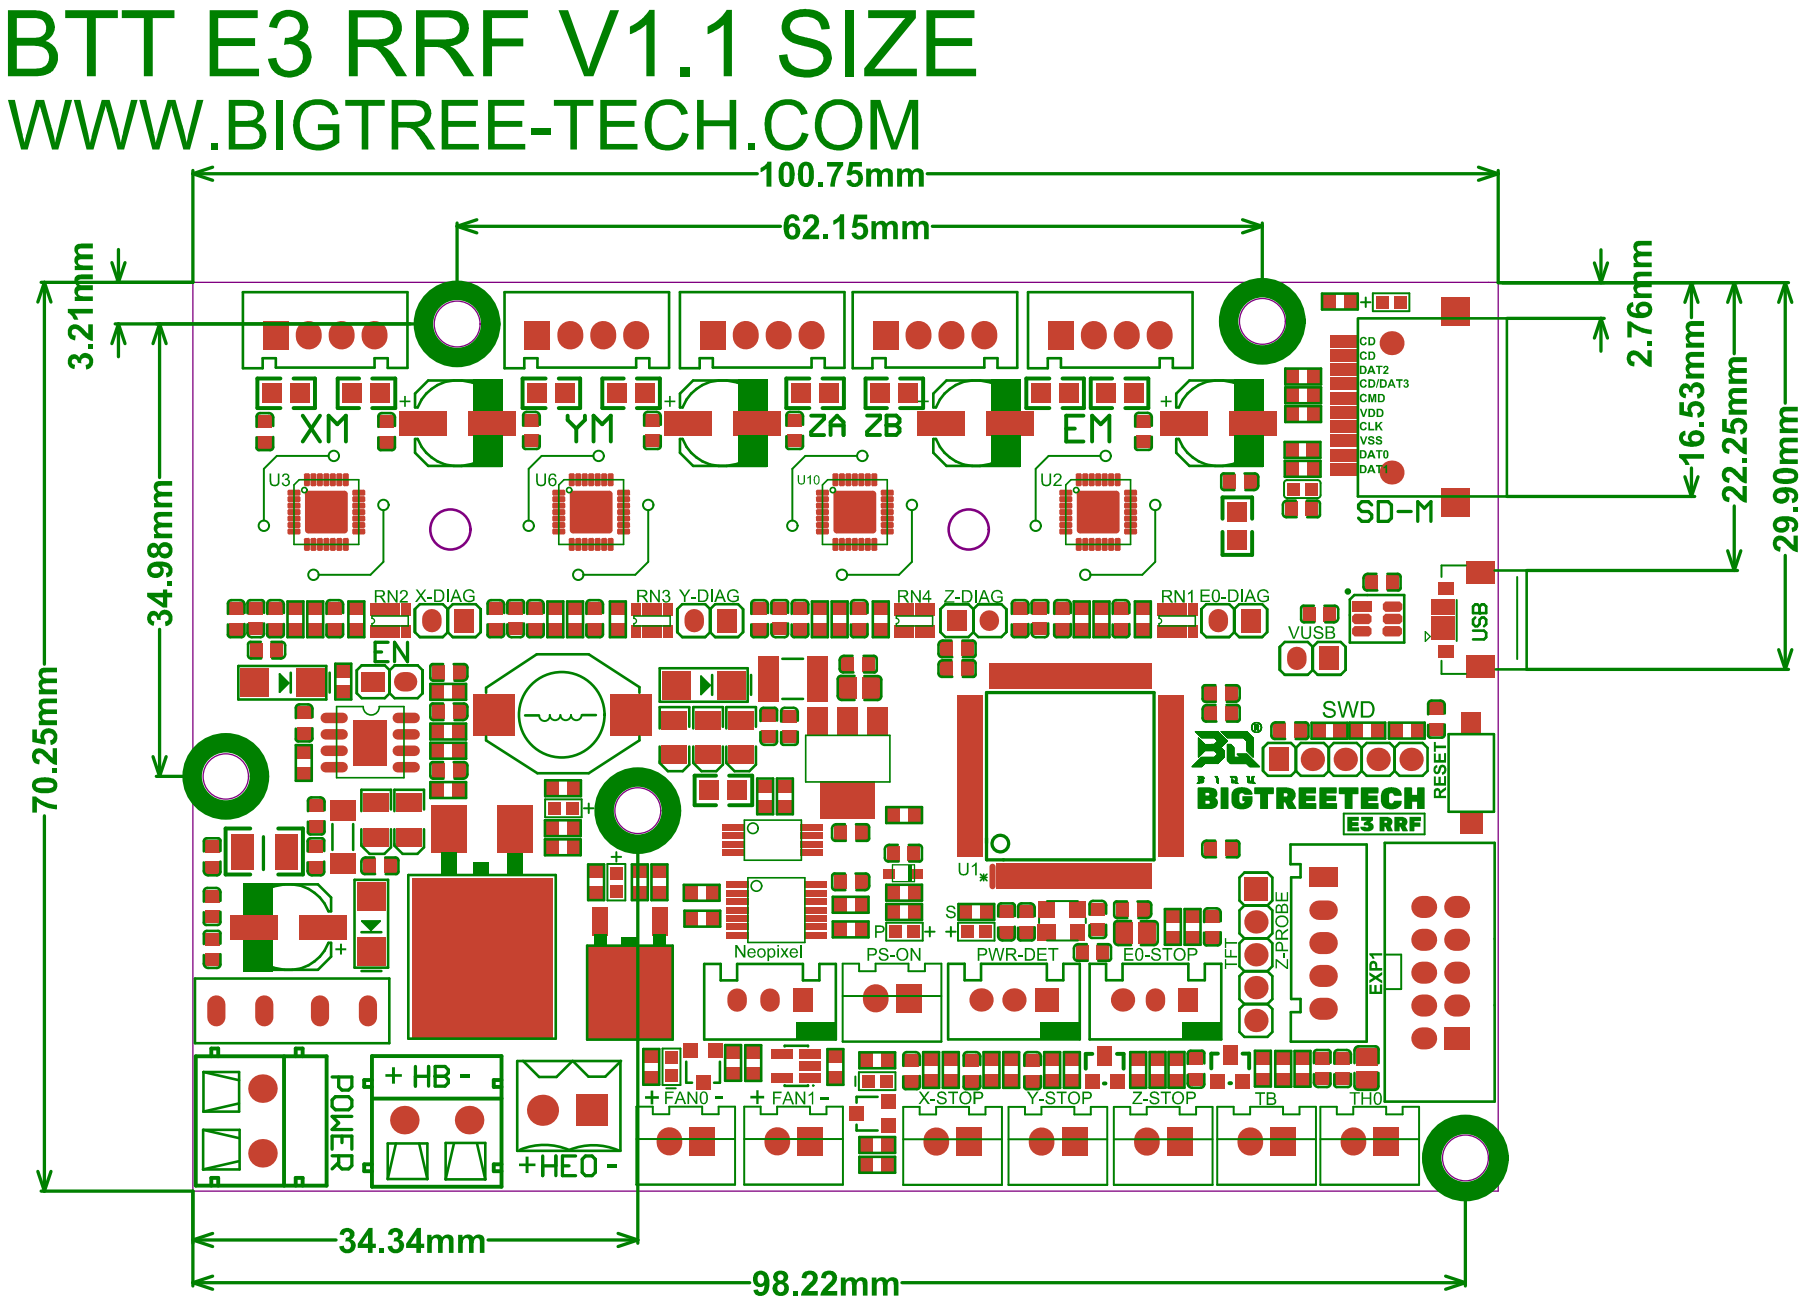
[picture p98: page 1]
