bigtreetech/BTT-E3-RRF/(commit log)

2021-03-16 BTT E3 RRF firmware
    [Configuration.h, Configuration_adv.h, bed.g, config-override.g, config.g, deployprobe.g, heightmap.csv, homeall.g]
2021-04-09 rrf config
    [config.g]
2021-04-10 RRF-IDEX-Expansion Board
2021-04-14 remove firmware, add readme, update board.txt
2021-04-27 TFT auto goto print menu when print by DWC
    [pause.g, resume.g, start.g, stop.g]
2021-06-09 MARLIN ESPD3D (#15)
