bigtreetech/BTT-E3-RRF/(notices)

Notices in the files:
BTT E3 RRF V1.1/Firmware/Marlin/Ender3/Marlin-2.0.7.2.x-E3-RRF/Marlin/Configuration_adv.h:
Copyright (c) 2020 MarlinFirmware [https://github.com/MarlinFirmware/Marlin]
Copyright (c) 2011 Camiel Gubbels / Erik van der Zalm
This program is free software: you can redistribute it and/or modify
it under the terms of the GNU General Public License as published by
the Free Software Foundation, either version 3 of the License, or
(at your option) any later version.
define TOUCH_UI_UTF8_COPYRIGHT // © ®
